modpack-robotics/modpack-robotics.github.io/docs/index.md

---
description: "Build and use ModPack: bill of materials, assembly guides, and software setup for the open-source robot teleoperation backpack."
---

# ModPack

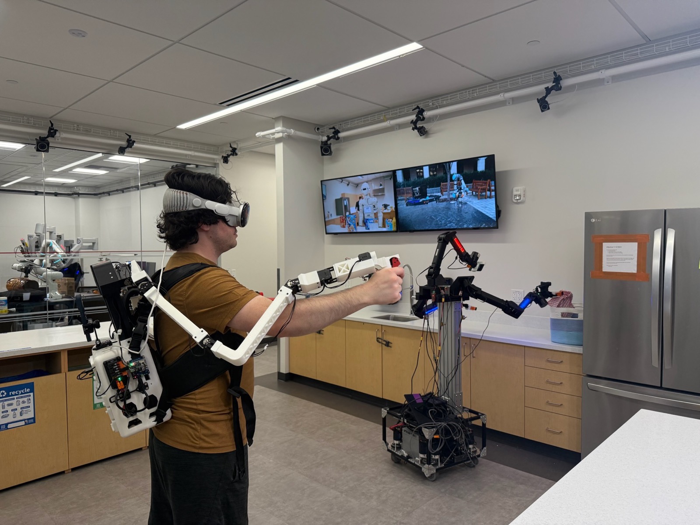
[picture p1: docs/images/arms_teleop_photo.jpg]
ModPack


## Where to Start
These docs contain hardware build instructions as well as a high-level overview of the software layout. For details on running the software for teleoperation, see the software repository.

<div class="nav-cards">
  <a class="nav-card" href="bom/">
    <span class="nav-card-title">Bill of Materials</span>
    <span class="nav-card-desc">Parts list with pricing and vendor links.</span>
  </a>
  <a class="nav-card" href="assembly/">
    <span class="nav-card-title">Assembly</span>
    <span class="nav-card-desc">Build the backpack and leader arms.</span>
  </a>
  <a class="nav-card" href="software/">
    <span class="nav-card-title">Software</span>
    <span class="nav-card-desc">Install and configure the ModPack software stack.</span>
  </a>
</div>
