modpack-robotics/modpack-robotics.github.io/docs/images/arx5_motor_orientation.png

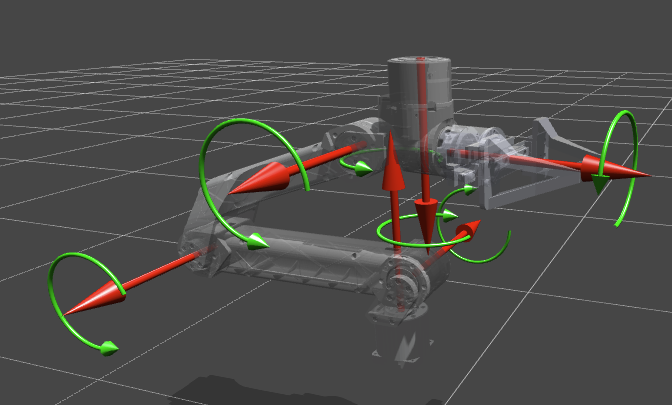
docs/images/arx5_motor_orientation.png
