modpack-robotics/modpack-robotics.github.io/docs/images/backpack_exploded.png

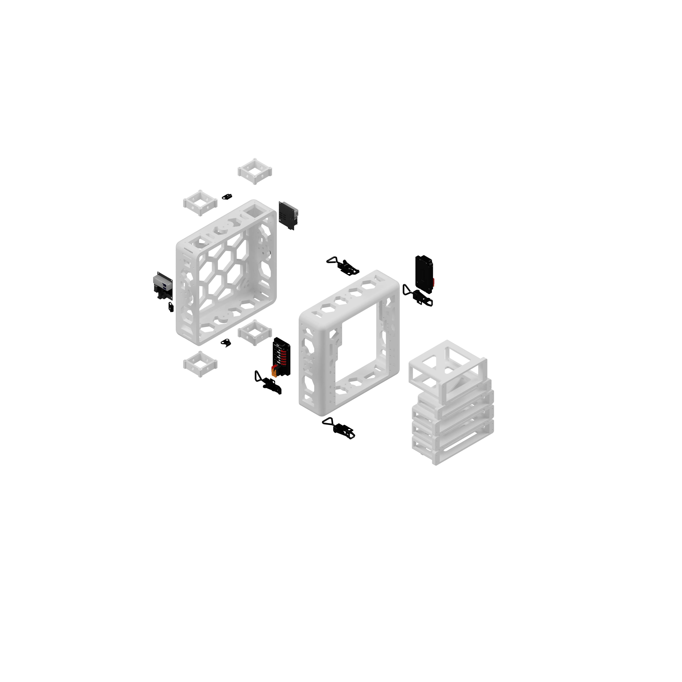
docs/images/backpack_exploded.png
