modpack-robotics/modpack-robotics.github.io/docs/images/rby1m_motor_orientation.png

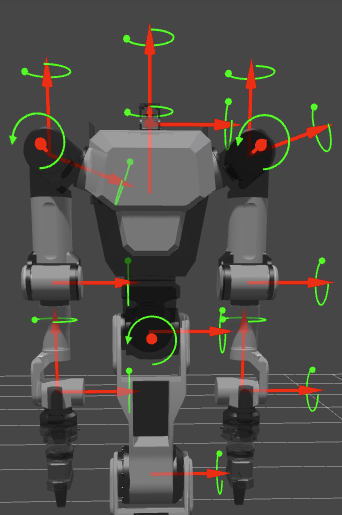
docs/images/rby1m_motor_orientation.png
