modpack-robotics/modpack-robotics.github.io/images/og_card.png

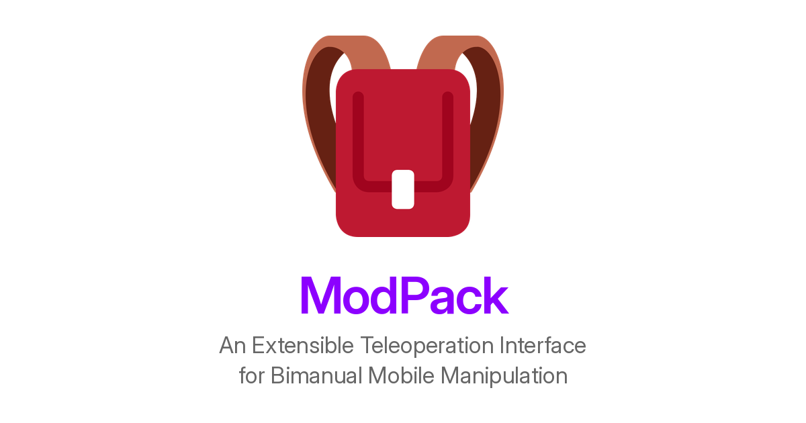
images/og_card.png
