modpack-robotics/modpack-robotics.github.io/images/teaser_v4.png

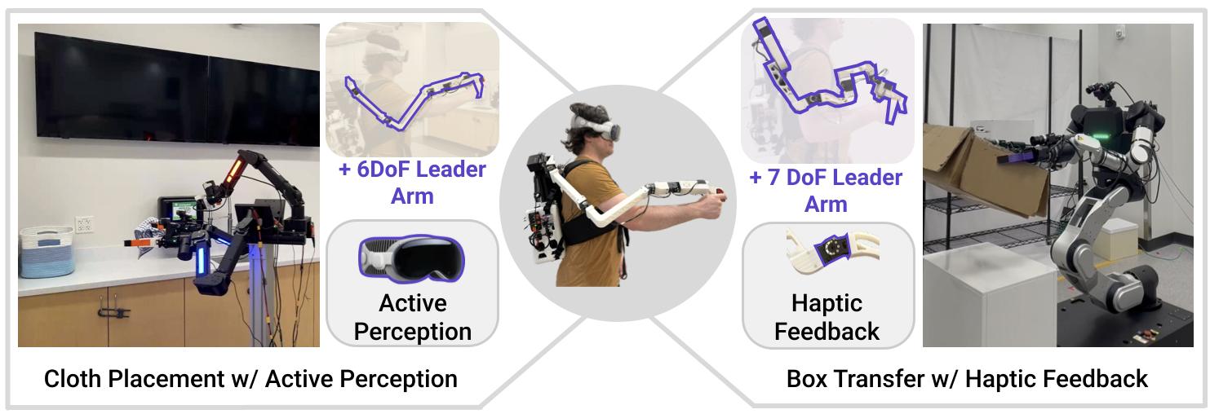
images/teaser_v4.png
