modpack-robotics/modpack-robotics.github.io/videos/posters/all-bad-grasp.jpg

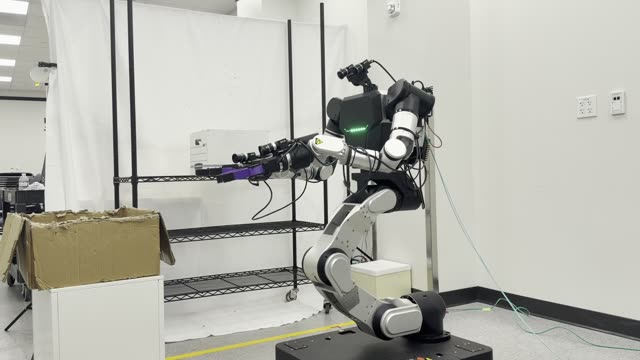
videos/posters/all-bad-grasp.jpg
