modpack-robotics/modpack-robotics.github.io/videos/posters/all-base-overshoot.jpg

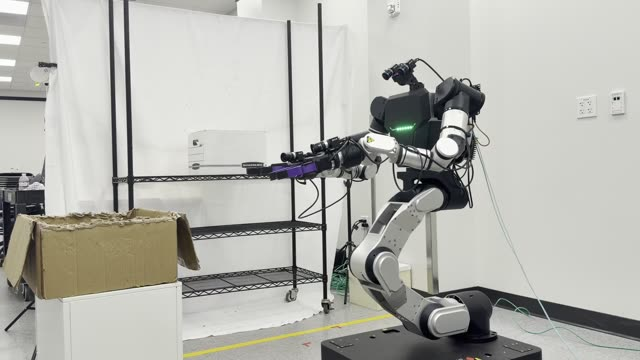
videos/posters/all-base-overshoot.jpg
