modpack-robotics/modpack-robotics.github.io/videos/posters/all-cam-1.jpg

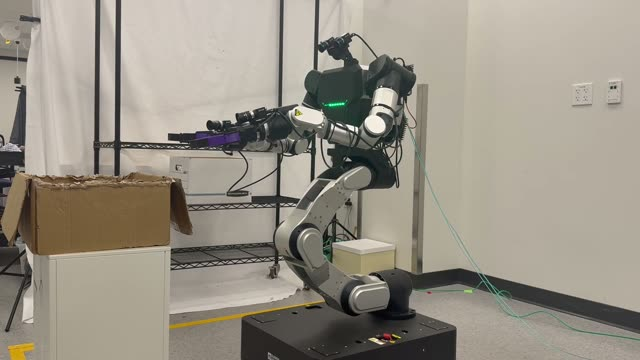
videos/posters/all-cam-1.jpg
