modpack-robotics/modpack-robotics.github.io/videos/posters/all-cam-2.jpg

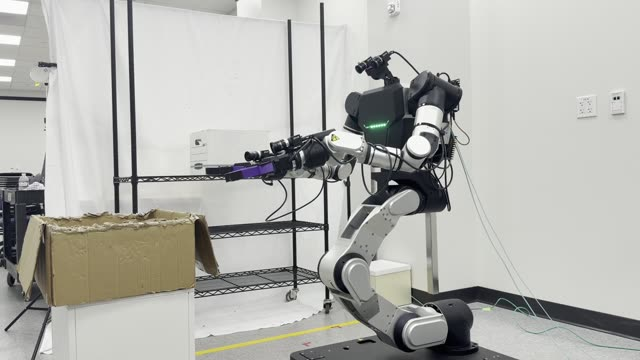
videos/posters/all-cam-2.jpg
