modpack-robotics/modpack-robotics.github.io/videos/posters/all-left-success.jpg

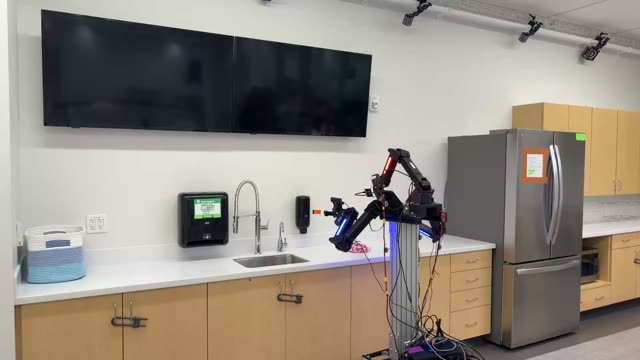
videos/posters/all-left-success.jpg
