modpack-robotics/modpack-robotics.github.io/videos/posters/all-torque-1.jpg

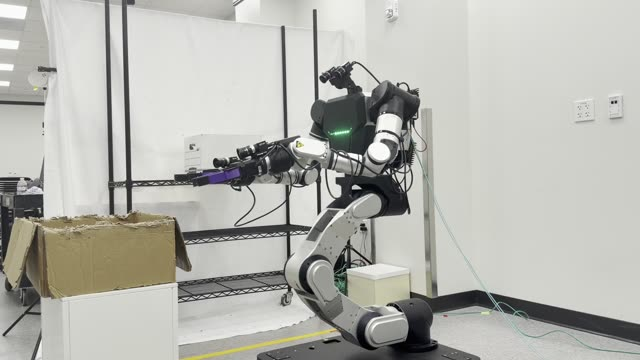
videos/posters/all-torque-1.jpg
