modpack-robotics/modpack-robotics.github.io/videos/posters/all-torque-2.jpg

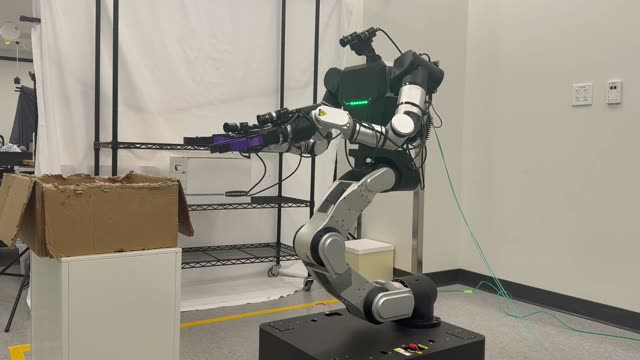
videos/posters/all-torque-2.jpg
