modpack-robotics/modpack-robotics.github.io/videos/posters/elevator_task.jpg

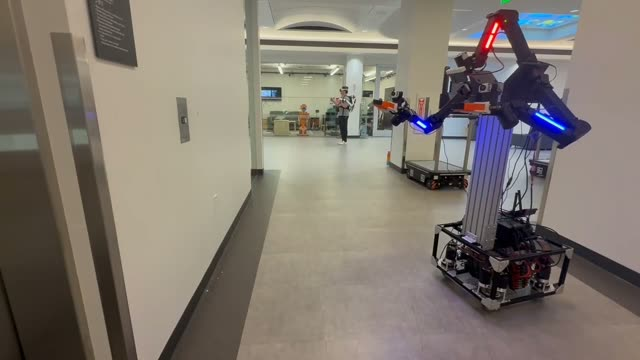
videos/posters/elevator_task.jpg
