modpack-robotics/modpack-robotics.github.io/videos/posters/fail-grasp-unblurred.jpg

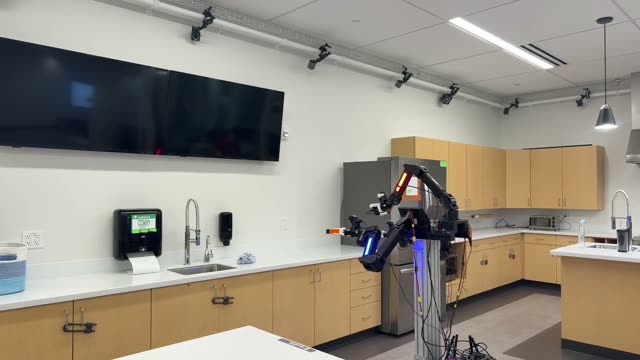
videos/posters/fail-grasp-unblurred.jpg
