modpack-robotics/modpack-robotics.github.io/videos/posters/head-near-collision.jpg

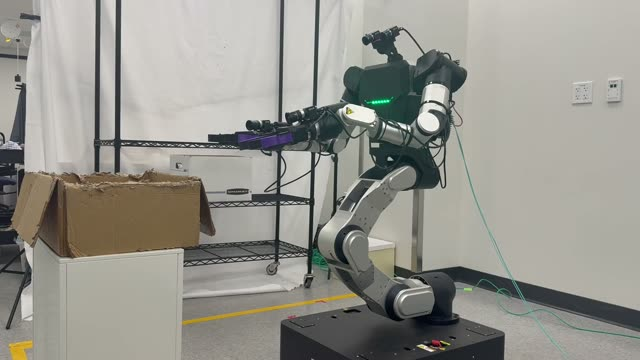
videos/posters/head-near-collision.jpg
