modpack-robotics/modpack-robotics.github.io/videos/posters/head-success-2.jpg

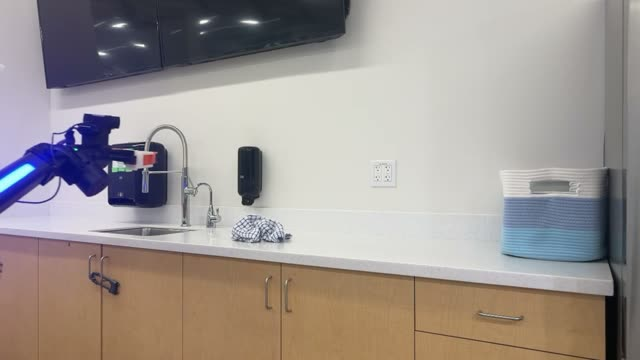
videos/posters/head-success-2.jpg
