modpack-robotics/modpack-robotics.github.io/videos/posters/head-success.jpg

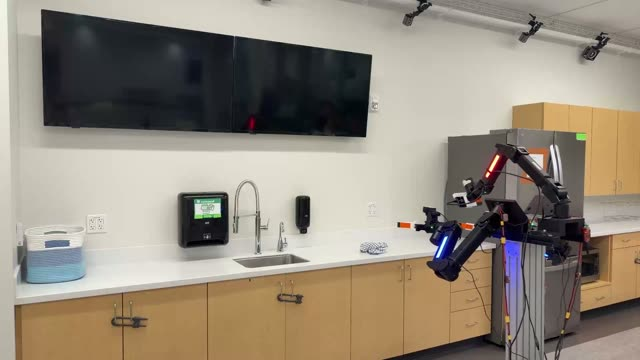
videos/posters/head-success.jpg
