modpack-robotics/modpack-robotics.github.io/videos/posters/kitchen_task.jpg

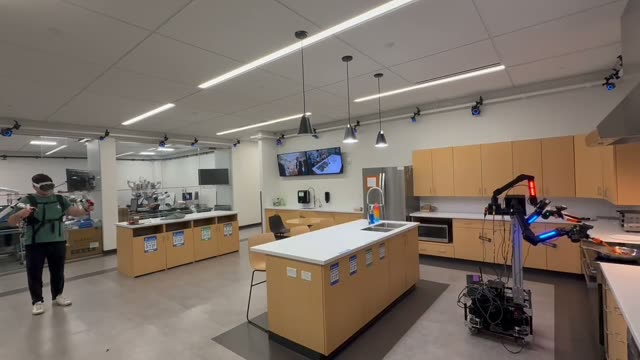
videos/posters/kitchen_task.jpg
