modpack-robotics/modpack-robotics.github.io/videos/posters/recycle_can.jpg

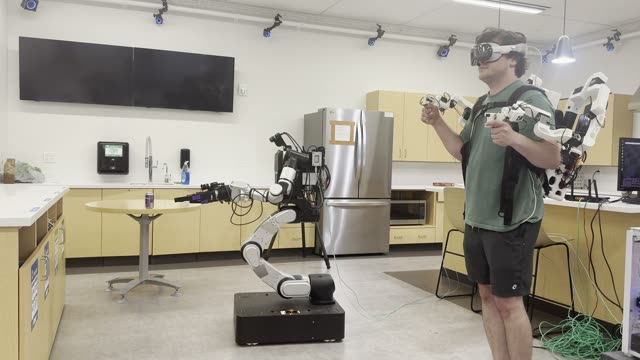
videos/posters/recycle_can.jpg
