modpack-robotics/modpack-robotics.github.io/videos/posters/Task 1 Teleop.jpg

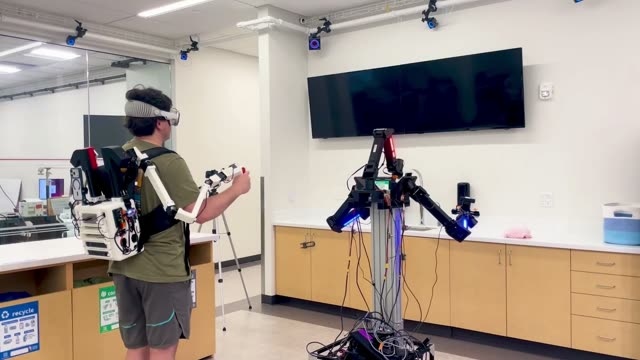
videos/posters/Task 1 Teleop.jpg
