modpack-robotics/modpack-robotics.github.io/videos/posters/task_2_teleop.jpg

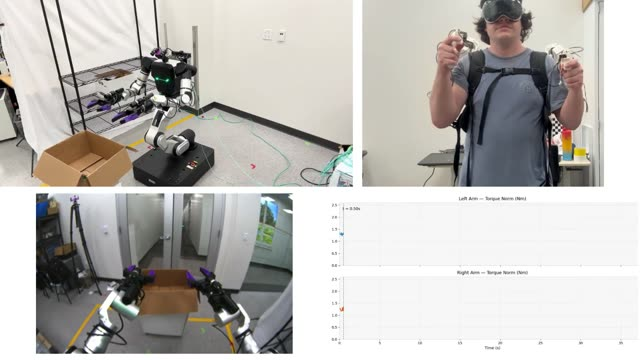
videos/posters/task_2_teleop.jpg
