modpack-robotics/modpack-robotics.github.io/videos/posters/task_2_teleop_lower.jpg

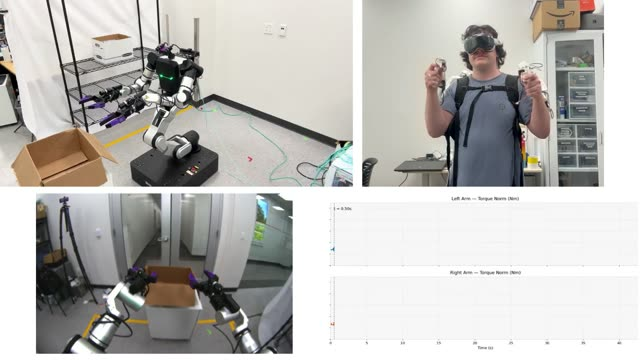
videos/posters/task_2_teleop_lower.jpg
