modpack-robotics/modpack-robotics.github.io/videos/posters/teaser.jpg

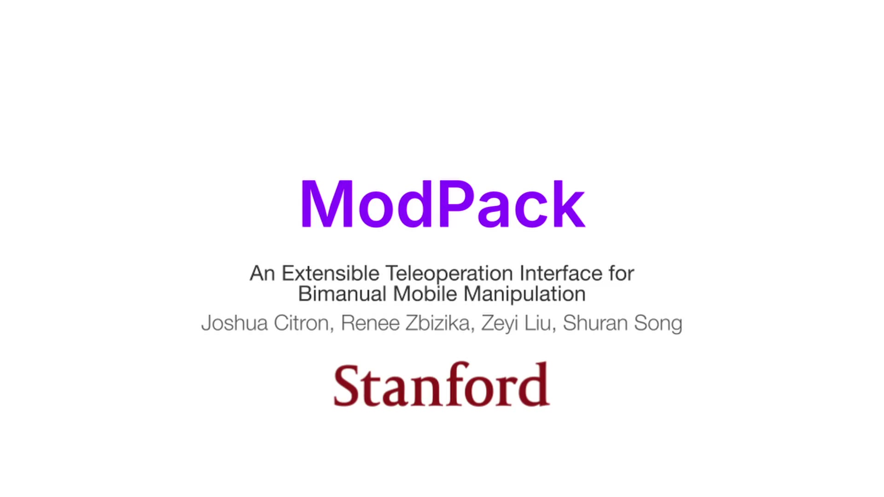
videos/posters/teaser.jpg
