modpack-robotics/modpack-robotics.github.io/docs/bom.md

---
description: Full parts list for building the ModPack teleoperation backpack and leader arms, with pricing and vendor links.
---

# Bill of Materials

### Backpack

| Item | Unit Cost | Qty | Total | Notes |
|---|---|-----|---|---|
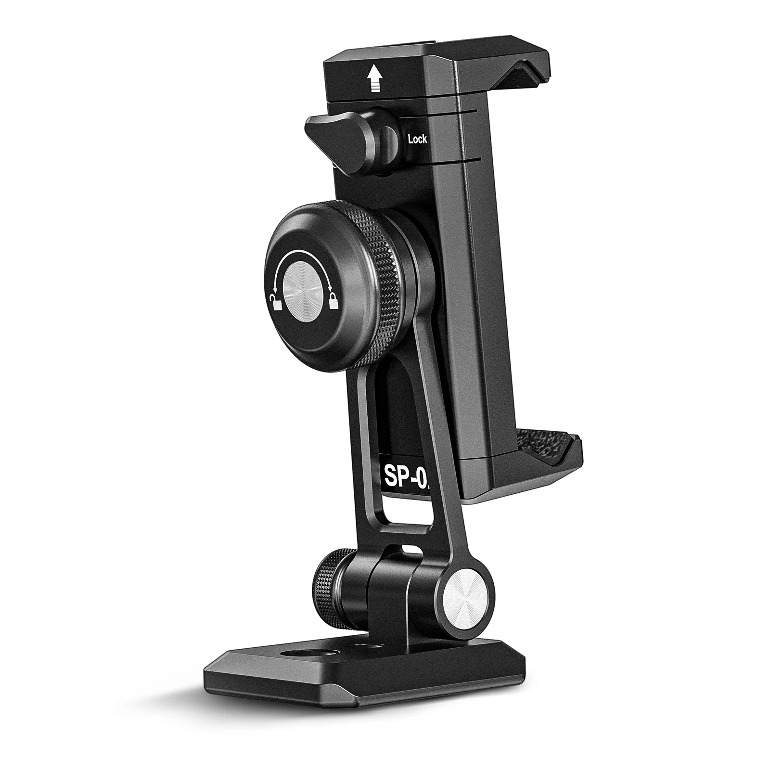
[picture p26: docs/images/bom/phone_mount.png]
| <div class="bom-item bom-item-lg"><span>Phone Mount</span></div> | $27.99 [[Amazon](https://www.amazon.com/NEEWER-SP-02-Cleaning-Cloth-Compatible/dp/B0FHW3ZXNM)] | 1 | $27.99 | |
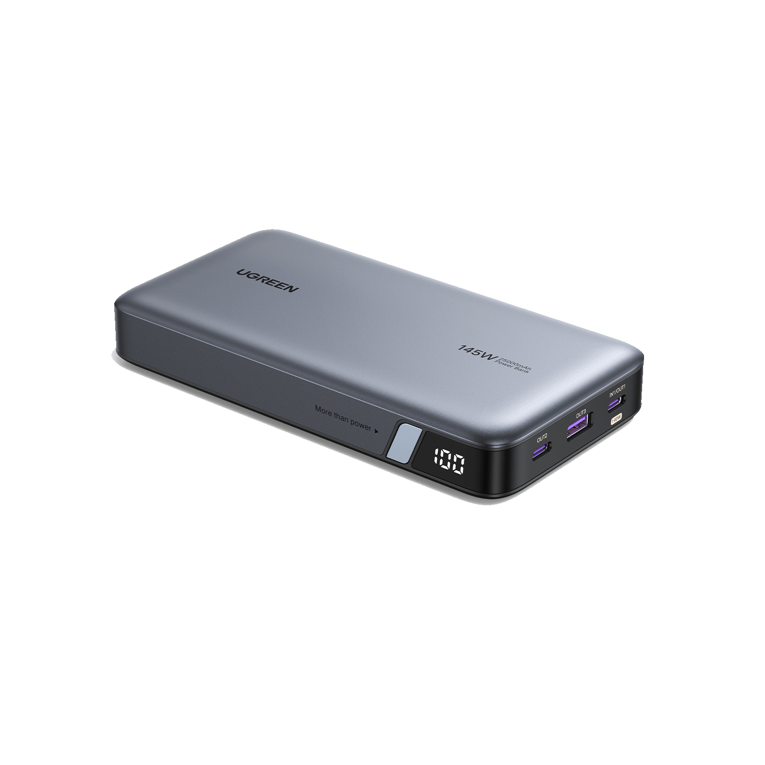
[picture p27: docs/images/bom/ugreen-145w.png]
| <div class="bom-item bom-item-lg" id="ugreen-145w"><span>UGREEN 145W Power Bank</span></div> | $109.99 [[UGREEN](https://www.ugreen.com/products/ugreen-145w-power-bank-for-laptop)] | 3 | $329.97 | |
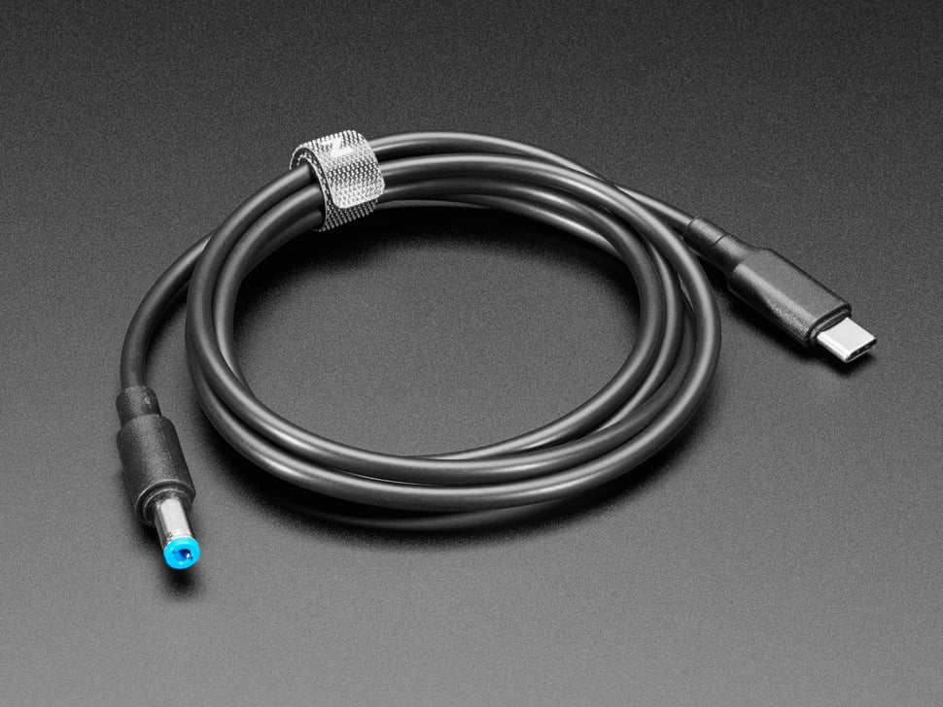
[picture p28: docs/images/bom/adafruit-5450.jpg]
| <div class="bom-item bom-item-lg" id="pd-trigger-cable"><span>PD Trigger Cable</span></div> | $7.95 [[Adafruit](https://www.adafruit.com/product/5450)] | 2 | $15.90 | |
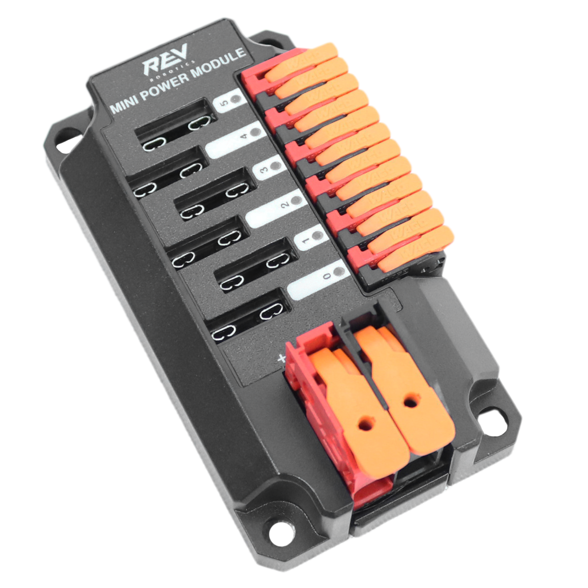
[picture p29: docs/images/bom/rev-mini-power-module.png]
| <div class="bom-item bom-item-lg" id="rev-mini-pdp"><span>Mini Power Module</span></div> | $38.00 [[REV Robotics](https://www.revrobotics.com/rev-11-1956/)] | 2 | $76.00 | |
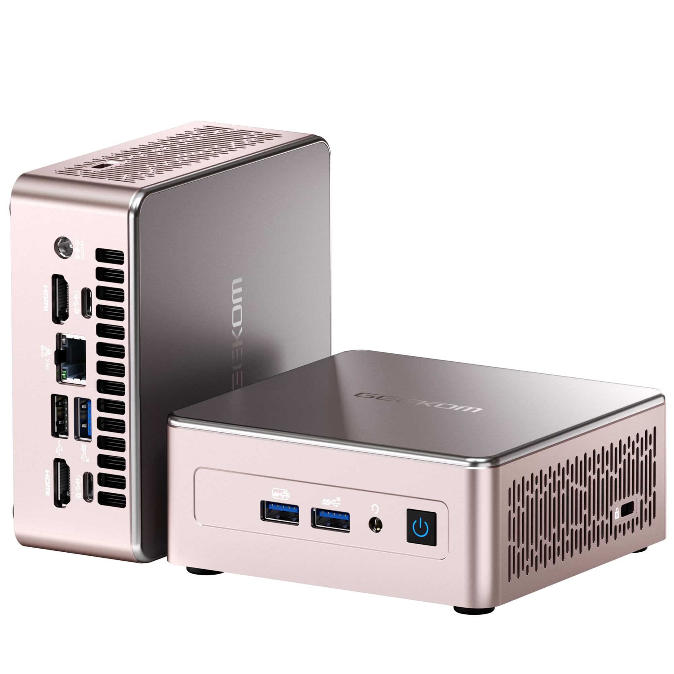
[picture p30: docs/images/bom/geekom-a5.jpg]
| <div class="bom-item bom-item-lg" id="geekom-a5"><span>GEEKOM A5 Mini PC</span></div> | $439.00 [[GEEKOM](https://www.geekompc.com/geekom-a5-mini-pc/)] | 1 | $439.00 | |
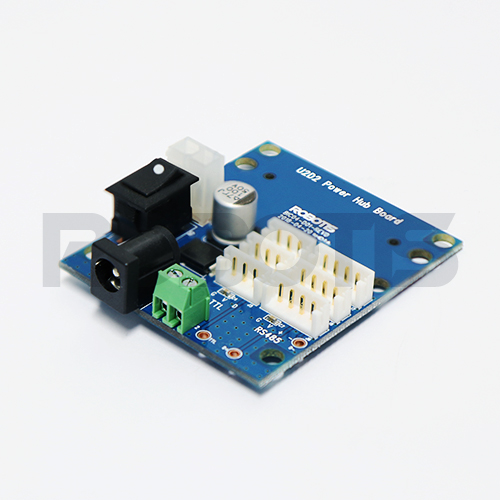
[picture p31: docs/images/bom/u2d2-power-hub.jpg]
| <div class="bom-item bom-item-lg" id="u2d2-power-hub"><span>U2D2 Power Hub Board</span></div> | $21.85 [[Robotis](https://www.robotis.us/u2d2-power-hub-board-set/)] | 2 | $43.70 | |
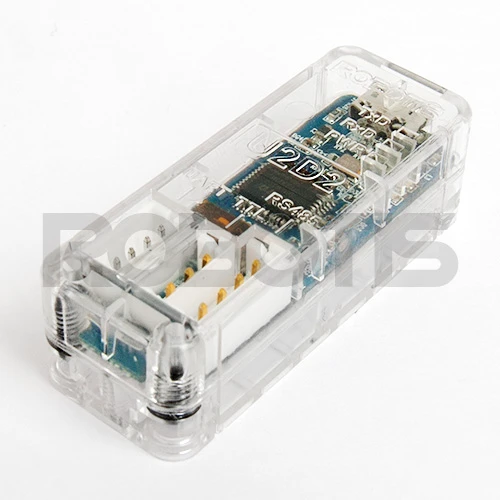
[picture p32: docs/images/bom/u2d2.webp]
| <div class="bom-item bom-item-lg" id="u2d2"><span>U2D2</span></div> | $36.92 [[Robotis](https://www.robotis.us/u2d2/)] | 2 | $73.84 | |
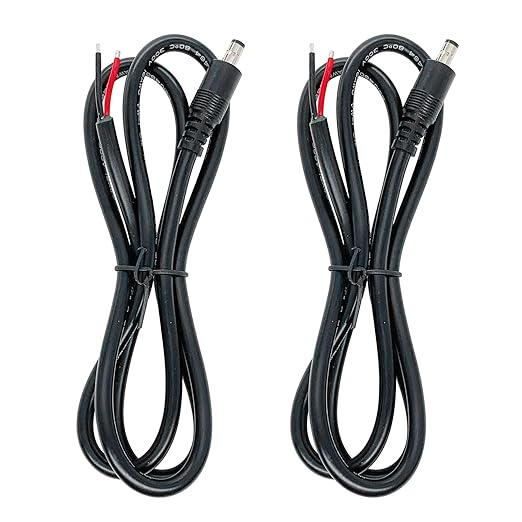
[picture p33: docs/images/bom/dc-barrel-male.jpg]
| <div class="bom-item bom-item-lg" id="dc-barrel-male"><span>DC Barrel Male Pigtail</span></div> | $13.99 [[Amazon](https://www.amazon.com/dp/B0CYBXK4ZW)] | 2 | $27.98 | |
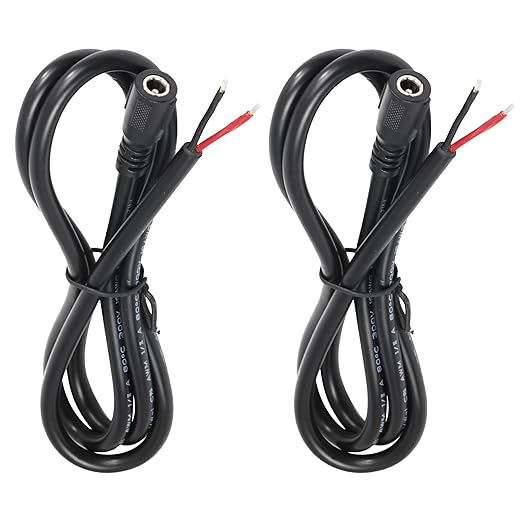
[picture p34: docs/images/bom/dc-barrel-female.jpg]
| <div class="bom-item bom-item-lg" id="dc-barrel-female"><span>DC Barrel Female Pigtail</span></div> | $12.49 [[Amazon](https://www.amazon.com/dp/B0DLW8692F)] | 2 | $24.98 | |
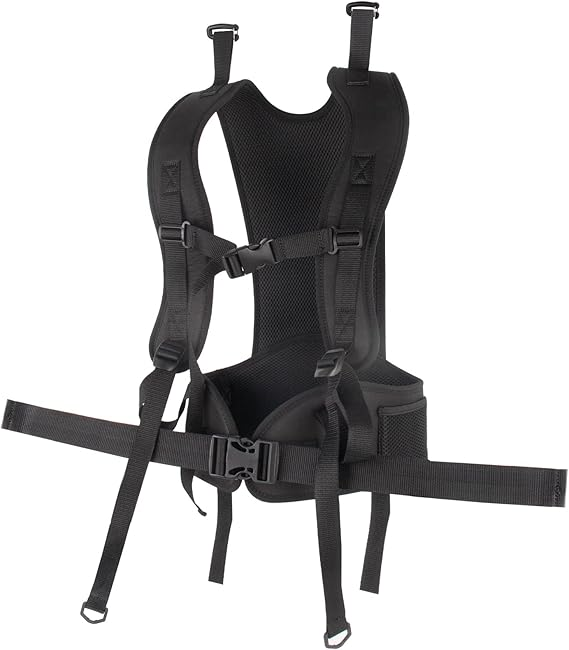
[picture p35: docs/images/bom/backpack-straps.jpg]
| <div class="bom-item bom-item-lg"><span>Backpack Straps</span></div> | $38.89 [[Amazon](https://www.amazon.com/dp/B0DHL1KNZ7)] | 1 | $38.89 | |
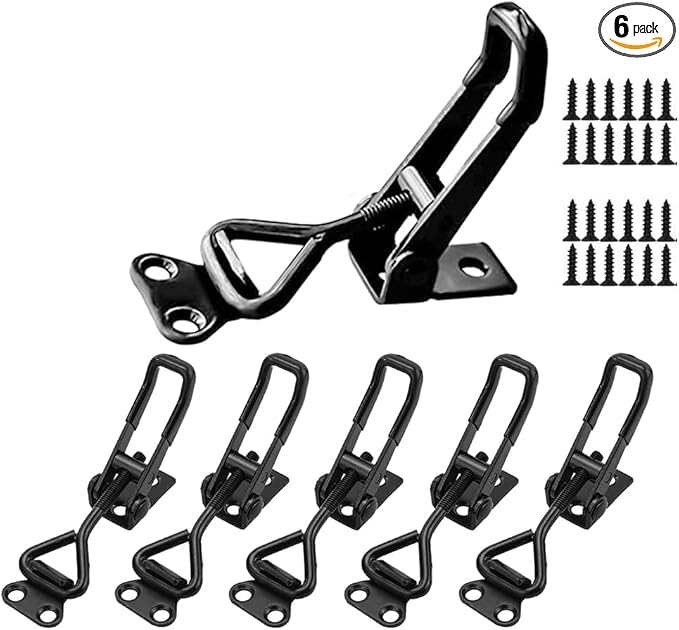
[picture p36: docs/images/bom/latch.jpg]
| <div class="bom-item bom-item-lg" id="latch"><span>Latch</span></div> | $7.95 [[Amazon](https://www.amazon.com/dp/B0C7BGH1Y9)] | 1 | $7.95 | |
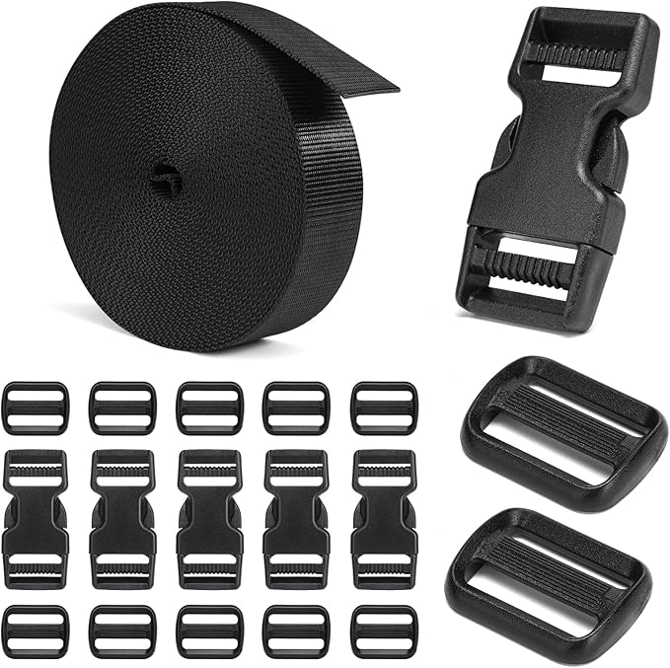
[picture p37: docs/images/bom/straps.jpg]
| <div class="bom-item bom-item-lg"><span>Shoulder Straps</span></div> | $9.99 [[Amazon](https://www.amazon.com/dp/B08LD8CJ8D)] | 1 | $9.99 | |
| <div class="bom-item" id="93625A200"><span>93625A200<br><small>M5 Nylon Lock Nut</small></span></div> | $9.62 [[McMaster](https://www.mcmaster.com/93625A200/)] | 1 pkg | $9.62 | |
| <div class="bom-item"><span>94180A321<br><small>M2.5x3.4 Heat-Set Insert</small></span></div> | $17.56 [[McMaster](https://www.mcmaster.com/94180A321/)] | 1 pkg | $17.56 | Shared with arms — one package total |
| <div class="bom-item" id="91290A252"><span>91290A252<br><small>M5x25 Socket Head Screw</small></span></div> | $10.96 [[McMaster](https://www.mcmaster.com/91290A252/)] | 1 pkg | $10.96 | |
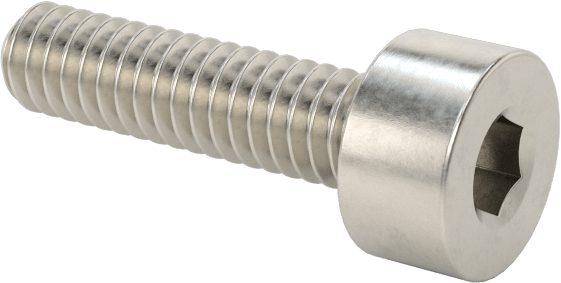
[picture p38: docs/images/bom/91292A832.png]
| <div class="bom-item" id="91292A832"><span>91292A832<br><small>M2x8 SS Socket Head</small></span></div> | $7.74 [[McMaster](https://www.mcmaster.com/91292A832/)] | 1 pkg | $7.74 | |
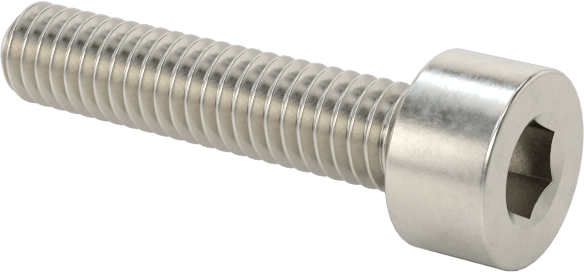
[picture p39: docs/images/bom/91292A016.png]
| <div class="bom-item" id="91292A016"><span>91292A016<br><small>M2.5x12 SS Socket Head</small></span></div> | $7.75 [[McMaster](https://www.mcmaster.com/91292A016/)] | 1 pkg | $7.75 | |
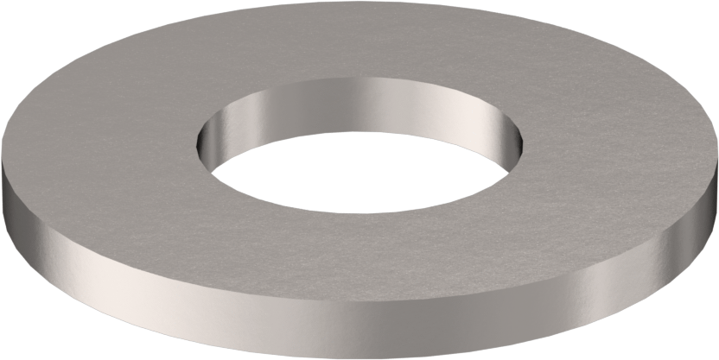
[picture p40: docs/images/bom/93475A210.png]
| <div class="bom-item" id="93475A210"><span>93475A210<br><small>M2.5 SS Washer</small></span></div> | $2.89 [[McMaster](https://www.mcmaster.com/93475A210/)] | 1 pkg | $2.89 | |
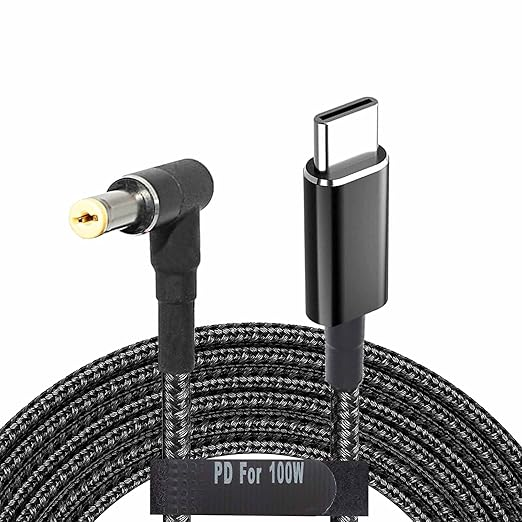
[picture p41: docs/images/bom/pc-cable.jpg]
| <div class="bom-item bom-item-lg" id="pc-cable"><span>100W PD 19V Laptop Charging Cable</span></div> | $14.98 [[Amazon](https://www.amazon.com/dp/B09X3V58M4)] | 1 | $14.98 | |
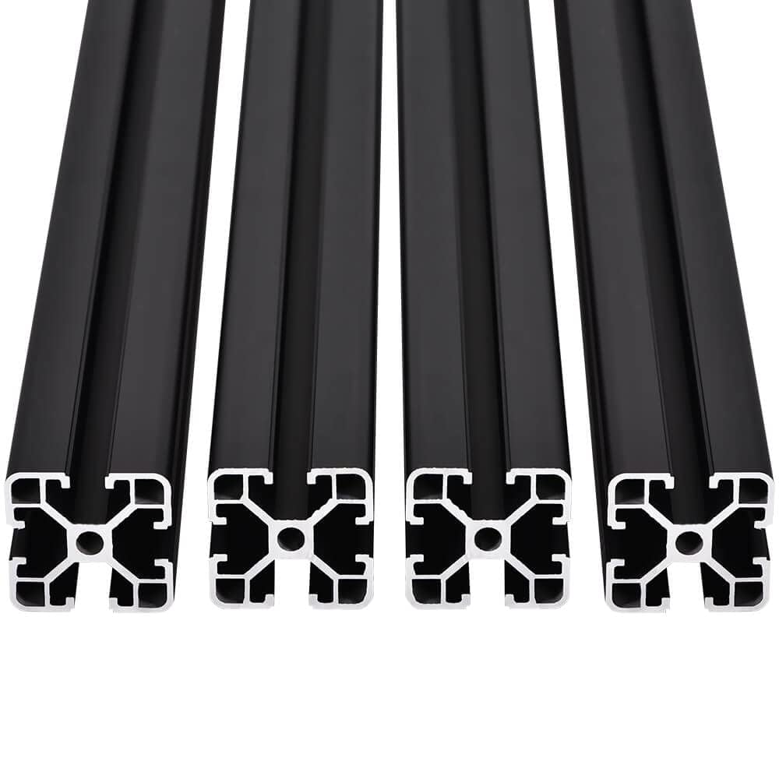
[picture p42: docs/images/bom/40x40-extrusion.jpeg]
| <div class="bom-item bom-item-lg" id="40x40-extrusion"><span>40×40 T-Slot Aluminum Extrusion</span></div> | $52.99 [[Amazon](https://www.amazon.com/dp/B09MWCL2WH)] | 1 pkg | $52.99 | Pack of 4 |
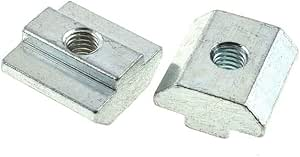
[picture p43: docs/images/bom/t-slot-sliding-nuts.jpg]
| <div class="bom-item bom-item-lg" id="t-slot-sliding-nuts"><span>T-Slot Sliding T-Nuts</span></div> | $8.99 [[Amazon](https://www.amazon.com/dp/B085BYLWJ2)] | 2 pkg | $17.98 | |

**Subtotal: $1,251.11**

---

### General Leader Arm (Both Variants)

| Item | Unit Cost | Qty | Total |
|---|---|-----|---|
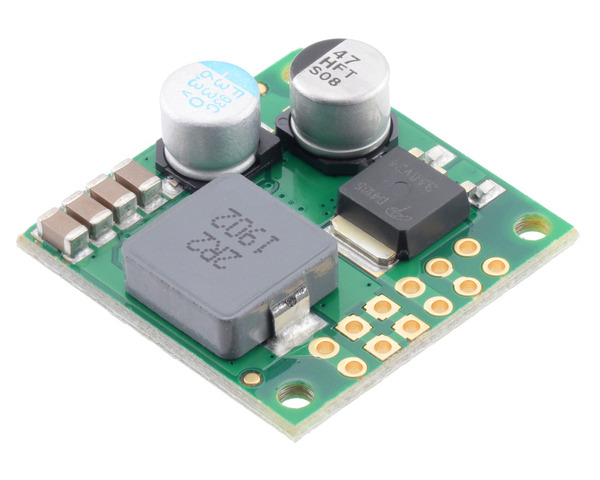
[picture p44: docs/images/bom/pololu-4091.jpg]
| <div class="bom-item"><span>D36V50F5 (5V Stepdown)</span></div> | $39.95 [[Pololu](https://www.pololu.com/product/4091)] | 2 | $79.90 |
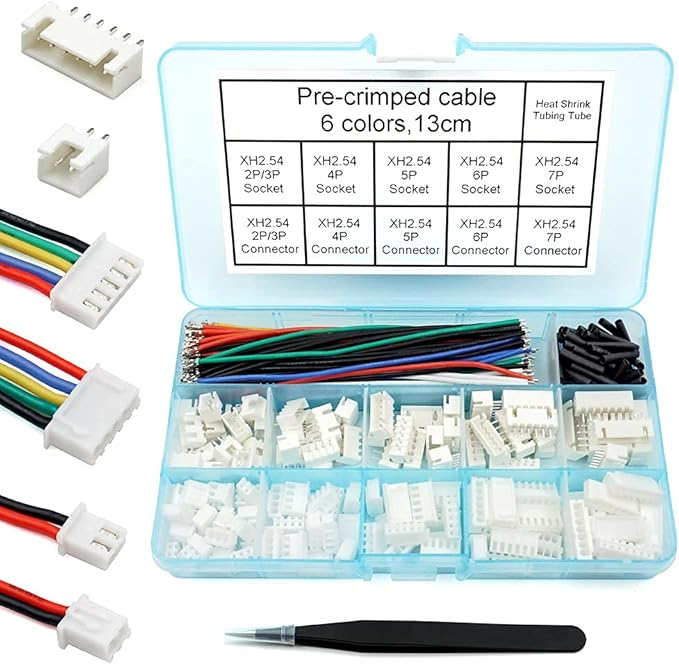
[picture p45: docs/images/bom/cables.jpg]
| <div class="bom-item" id="jst-wire-kit"><span>JST Connector Wire Kit</span></div> | $16.99 [[Amazon](https://www.amazon.com/dp/B08G188ZQ8)] | 1 pkg | $16.99 |
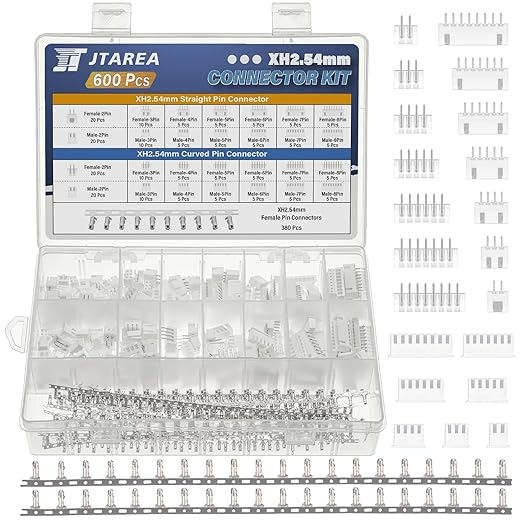
[picture p46: docs/images/bom/kit.jpg]
| <div class="bom-item" id="jst-xh-kit"><span>JST XH 2.54mm Connector Kit</span></div> | $8.99 [[Amazon](https://www.amazon.com/dp/B0F5QBR5F4)] | 1 pkg | $8.99 |
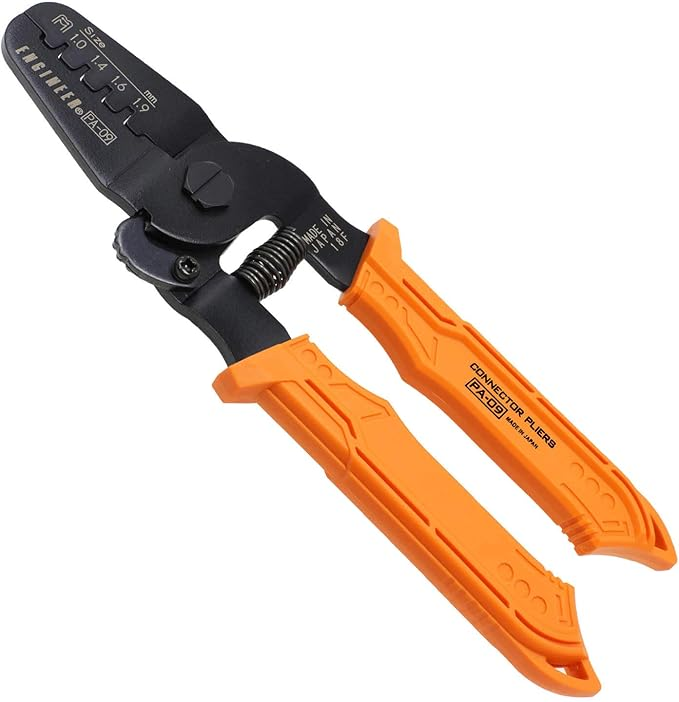
[picture p47: docs/images/bom/engineer_pa09.jpg]
| <div class="bom-item" id="engineer-pa09"><span>ENGINEER PA-09 Crimper</span></div> | $41.59 [[Amazon](https://www.amazon.com/dp/B002AVVO7K)] | 1 | $41.59 |
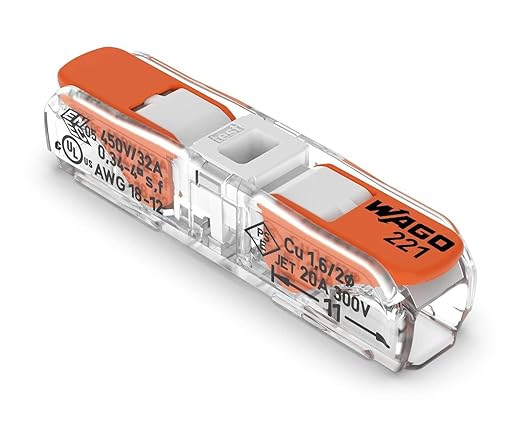
[picture p48: docs/images/bom/wago.jpg]
| <div class="bom-item" id="wago"><span>WAGO 221-2401 Lever Nuts</span></div> | $9.95 [[Amazon](https://www.amazon.com/dp/B0GFFF52V5)] | 1 pkg | $9.95 |
| <div class="bom-item"><span>92125A086<br><small>M2.5x8 SS Flat Head</small></span></div> | $6.50 [[McMaster](https://www.mcmaster.com/92125A086/)] | 1 pkg | $6.50 |
| <div class="bom-item"><span>94180A323<br><small>M2.5x5.6 Heat-Set Insert</small></span></div> | $24.72 [[McMaster](https://www.mcmaster.com/94180A323/)] | 1 pkg | $24.72 |
| <div class="bom-item"><span>91294A020<br><small>M2.5x12 Black Flat Head</small></span></div> | $6.45 [[McMaster](https://www.mcmaster.com/91294A020/)] | 1 pkg | $6.45 |
| <div class="bom-item" id="94180A321"><span>94180A321<br><small>M2.5x3.4 Heat-Set Insert</small></span></div> | $17.56 [[McMaster](https://www.mcmaster.com/94180A321/)] | 1 pkg | $17.56 |
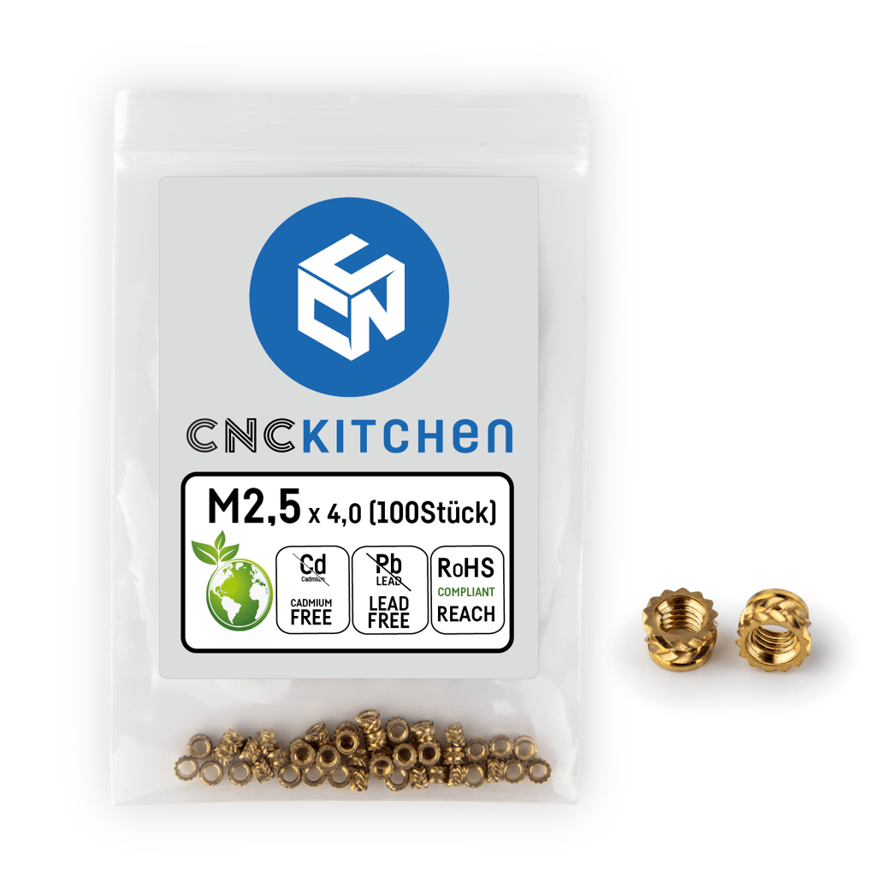
[picture p49: docs/images/bom/heat-set-insert-m2.png]
| <div class="bom-item" id="m2-heat-set"><span>M2 Heat-Set Inserts</span></div> | $8.99 [[Amazon](https://www.amazon.com/dp/B0CS6XJSSL)] | 1 pkg | $8.99 |
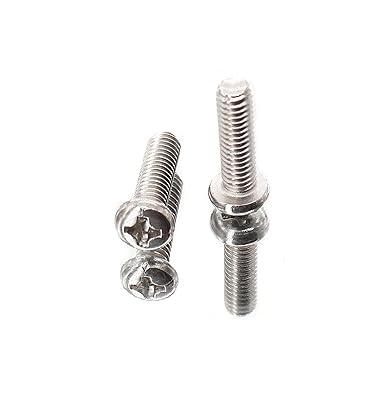
[picture p50: docs/images/bom/pan_head.jpg]
| <div class="bom-item" id="m2x6-screw"><span>M2x6 Pan Head Screw</span></div> | $4.69 [[Amazon](https://www.amazon.com/dp/B0CMCTX529)] | 1 pkg | $4.69 |
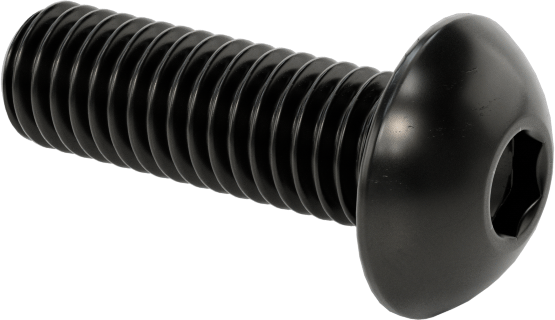
[picture p51: docs/images/bom/97763A822.png]
| <div class="bom-item" id="97763A822"><span>97763A822<br><small>M5x16 SS Button Head</small></span></div> | $6.66 [[McMaster](https://www.mcmaster.com/97763A822/)] | 1 pkg | $6.66 |
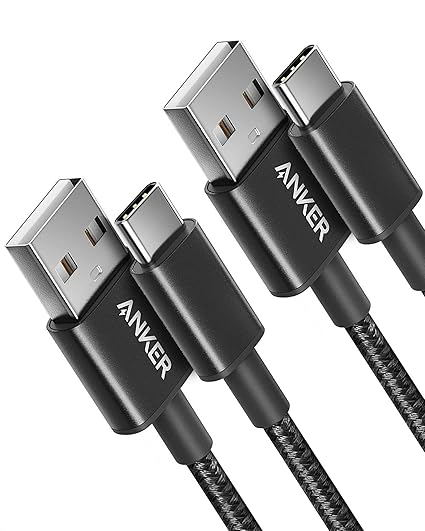
[picture p52: docs/images/bom/usbc-to-usb.jpg]
| <div class="bom-item" id="usbc-to-usb"><span>USB-C to USB Cable</span></div> | $8.99 [[Amazon](https://www.amazon.com/dp/B07DD5YHMH)] | 1 pkg | $8.99 |

**Subtotal: $241.98**

---

### ARX5 Leader Arm (6-DoF)

| Item | Unit Cost | Qty | Total |
|---|---|-----|---|
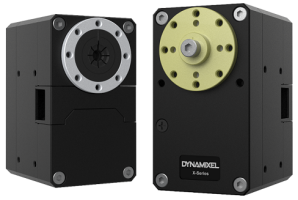
[picture p53: docs/images/bom/xm540-w270-t.png]
| <div class="bom-item"><span>XM540-W270-T</span></div> | $482.89 [[Robotis](https://robotis.us/dynamixel-xm540-w270-t/)] | 2 | $965.78 |
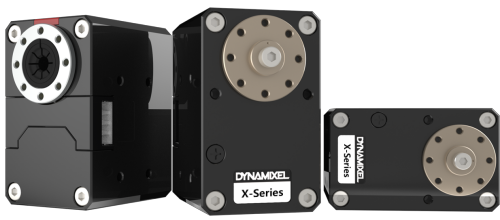
[picture p54: docs/images/bom/xm430-w350-t.png]
| <div class="bom-item"><span>XM430-W350-T</span></div> | $310.39 [[Robotis](https://www.robotis.us/dynamixel-xm430-w350-t/)] | 2 | $620.78 |
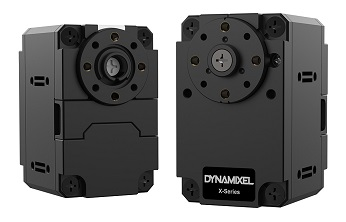
[picture p55: docs/images/bom/xl430-w250-t.png]
| <div class="bom-item"><span>XL430-W250-T</span></div> | $45.36 [[Robotis](https://www.robotis.us/dynamixel-xl430-w250-t/)] | 2 | $90.72 |
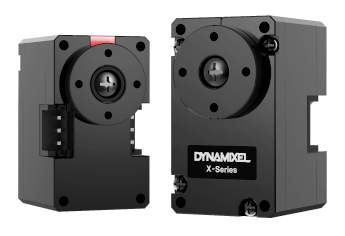
[picture p56: docs/images/bom/xl330-m288-t.png]
| <div class="bom-item"><span>XL330-M288-T</span></div> | $27.49 [[Robotis](https://www.robotis.us/dynamixel-xl330-m288-t/)] | 1 | $27.49 |
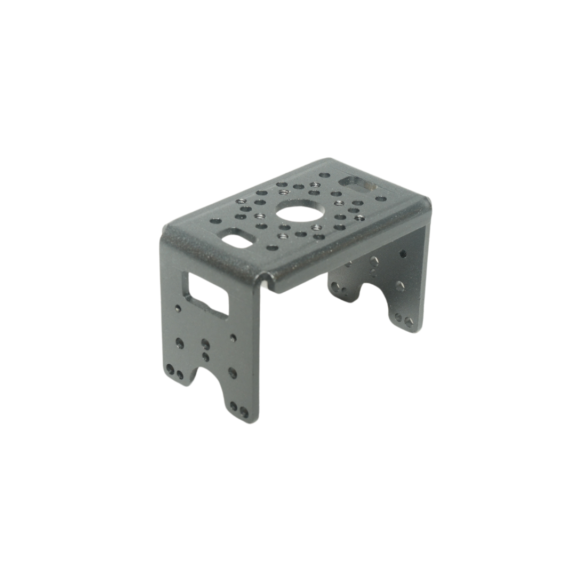
[picture p57: docs/images/bom/fr13.png]
| <div class="bom-item"><span>FR13</span></div> | $76.71 [[Robotis](https://www.robotis.us/fr13-h101k-set/)] | 2 | $153.42 |
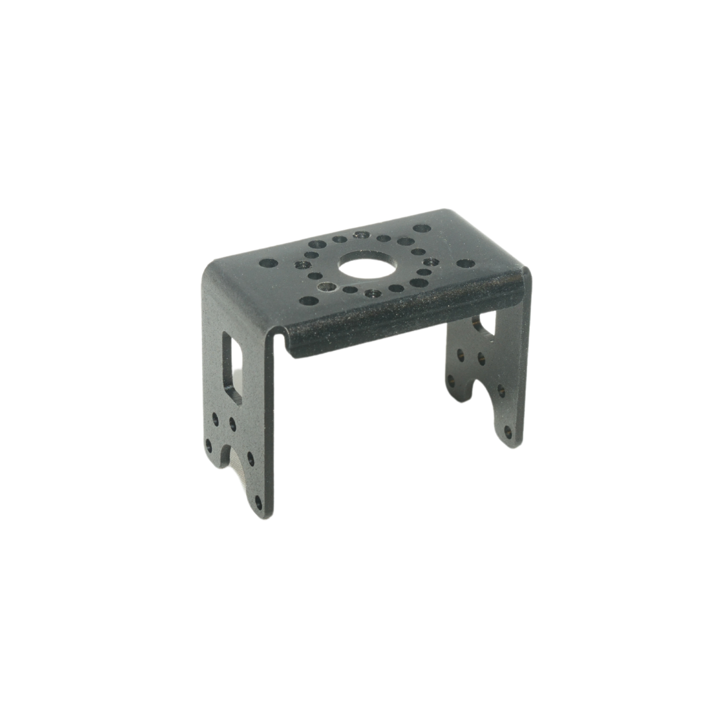
[picture p58: docs/images/bom/fr12.png]
| <div class="bom-item"><span>FR12</span></div> | $46.69 [[Robotis](https://www.robotis.us/fr12-h101k-set/)] | 3 | $140.07 |

**Subtotal: $1,998.26**

---

### RB-Y1m Leader Arm (7-DoF)

| Item | Unit Cost | Qty | Total |
|---|---|-----|---|
| <div class="bom-item"><span>XM540-W270-T</span></div> | $482.89 [[Robotis](https://robotis.us/dynamixel-xm540-w270-t/)] | 5 | $2,414.45 |
| <div class="bom-item"><span>XM430-W350-T</span></div> | $310.39 [[Robotis](https://www.robotis.us/dynamixel-xm430-w350-t/)] | 1 | $310.39 |
| <div class="bom-item"><span>XM430-W210-T</span></div> | $310.39 [[Robotis](https://www.robotis.us/dynamixel-xm430-w210-t/)] | 1 | $310.39 |
| <div class="bom-item"><span>XL330-M288-T</span></div> | $27.49 [[Robotis](https://www.robotis.us/dynamixel-xl330-m288-t/)] | 1 | $27.49 |
| <div class="bom-item"><span>FR13</span></div> | $76.71 [[Robotis](https://www.robotis.us/fr13-h101k-set/)] | 5 | $383.55 |
| <div class="bom-item" id="fr12-bracket-kit"><span>FR12</span></div> | $46.69 [[Robotis](https://www.robotis.us/fr12-h101k-set/)] | 1 | $46.69 |

**Subtotal: $3,492.96**

---

### Off-the-Shelf Devices

Required only for their respective modules; not included in the build subtotals above since many users already own them.

| Item | Unit Cost | Qty | Total | Notes |
|---|---|-----|---|---|
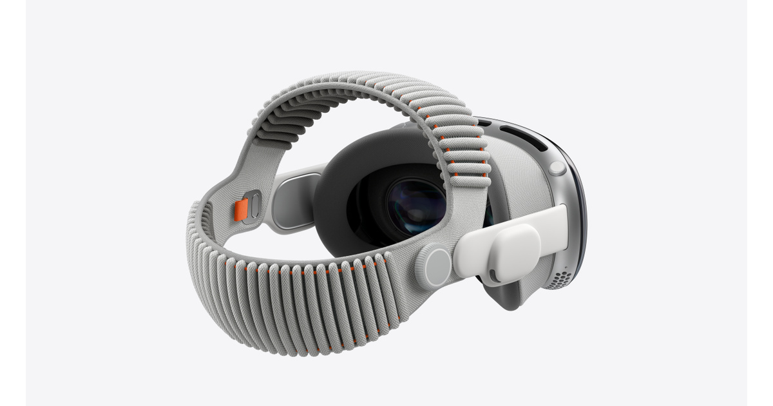
[picture p59: docs/images/bom/apple-vision-pro.jpg]
| <div class="bom-item bom-item-lg" id="apple-vision-pro"><span>Apple Vision Pro</span></div> | $3,699.00 [[Apple](https://www.apple.com/apple-vision-pro/)] | 1 | $3,699.00 | Head-tracking module |
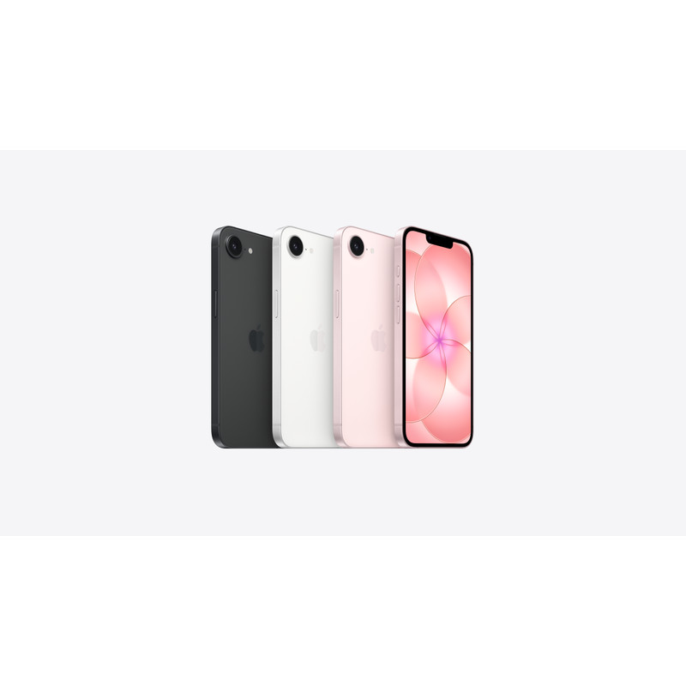
[picture p60: docs/images/bom/iphone-17e.jpg]
| <div class="bom-item bom-item-lg" id="iphone"><span>iPhone</span></div> | from $599.00 [[Apple](https://www.apple.com/shop/buy-iphone/iphone-17e)] | 1 | $599.00 | Base-control module; any recent iPhone works (mounts on the backpack phone mount) |
