modpack-robotics/modpack-robotics.github.io/docs/files/arx5/gripper.step

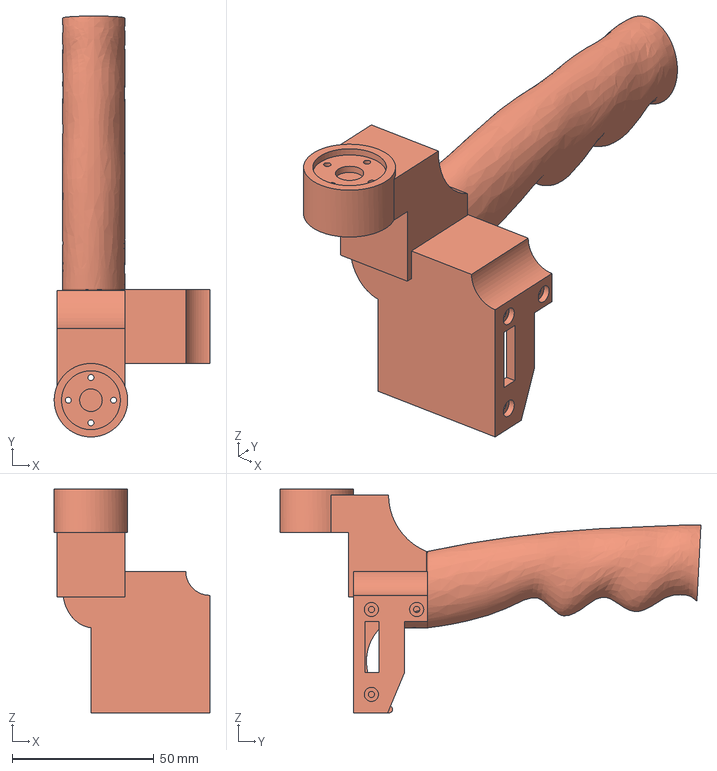
[picture p61: CAD file, 2026-07-21]
docs/files/arx5/gripper.step
55.0 x 148.7 x 79.0 mm
