modpack-robotics/modpack-robotics.github.io/docs/files/backpack/pc-holder.step

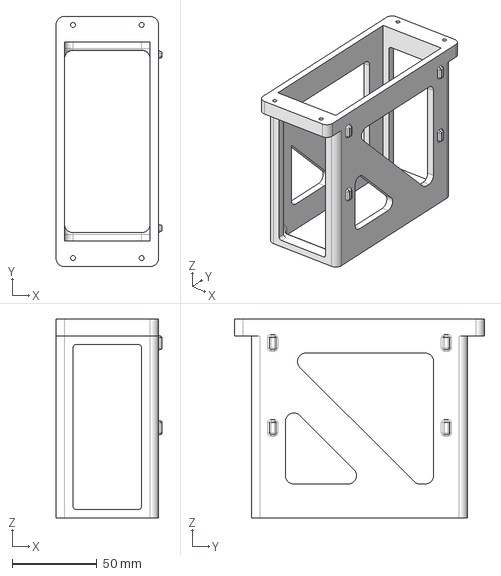
[picture p62: CAD file, 2026-07-21]
docs/files/backpack/pc-holder.step
62.4 x 147.2 x 117.1 mm
