modpack-robotics/modpack-robotics.github.io/docs/files/rby1m/left-shoulder.step

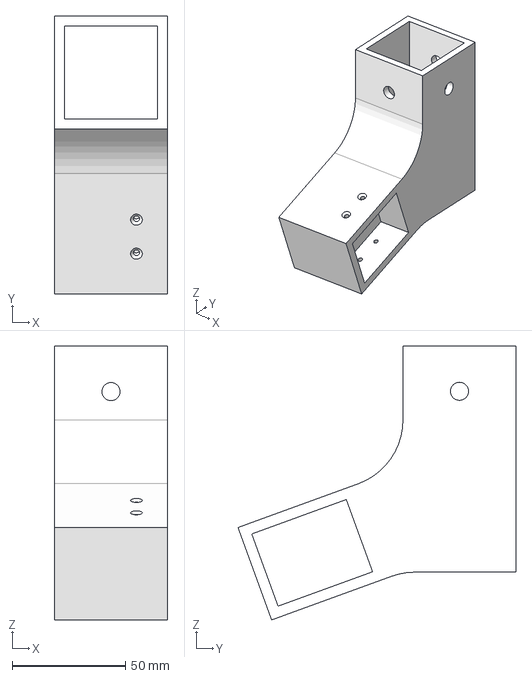
[picture p63: CAD file, 2026-07-21]
docs/files/rby1m/left-shoulder.step
50.0 x 123.0 x 121.1 mm
