modpack-robotics/modpack-robotics.github.io/docs/files/shared/trigger-right.step

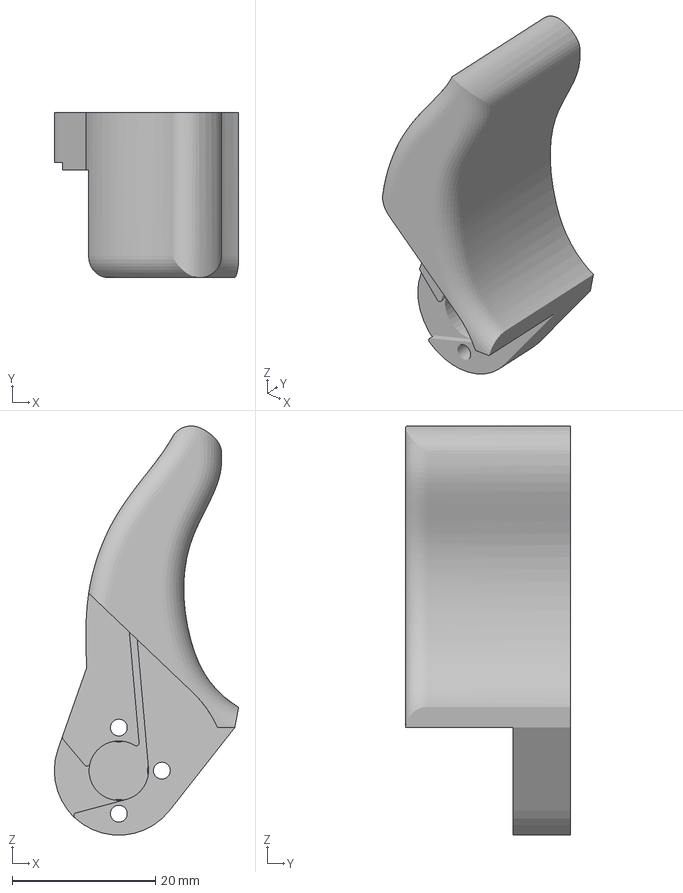
[picture p64: CAD file, 2026-07-21]
docs/files/shared/trigger-right.step
25.7 x 23.0 x 57.0 mm
