modpack-robotics/modpack-robotics.github.io/models/backpack_parts/part_10.step

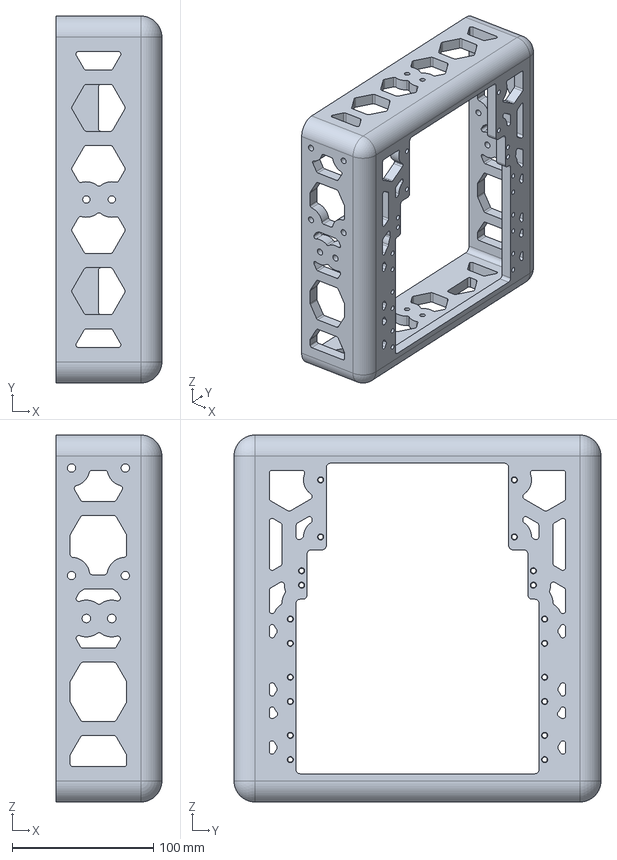
[picture p65: CAD file, 2026-07-21]
models/backpack_parts/part_10.step
75.0 x 260.0 x 260.0 mm
