modpack-robotics/modpack-robotics.github.io/docs/files/backpack/vp-charger-holder.step

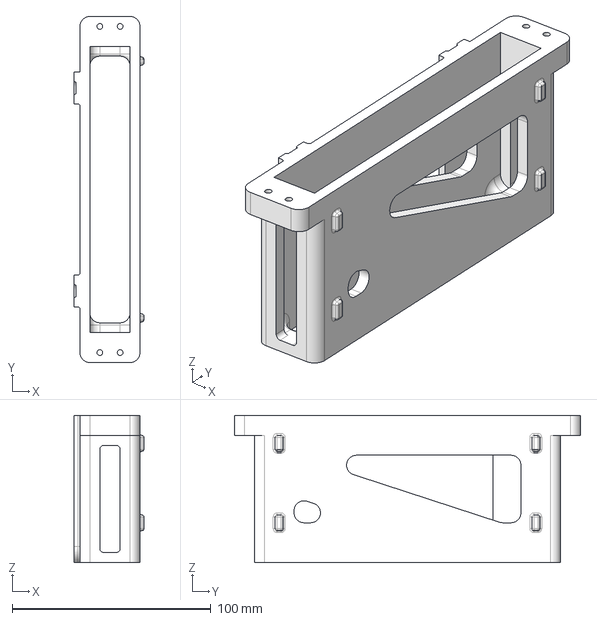
[picture p66: CAD file, 2026-07-21]
docs/files/backpack/vp-charger-holder.step
35.2 x 174.2 x 74.0 mm
