modpack-robotics/modpack-robotics.github.io/models/arm_right/step/Right Arm - Part 2.step

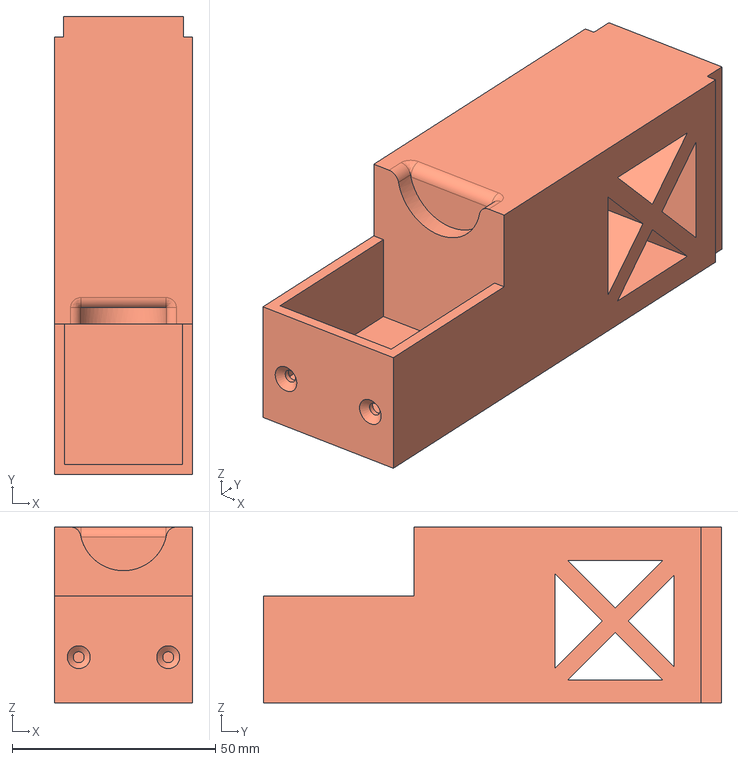
[picture p67: CAD file, 2026-07-21]
models/arm_right/step/Right Arm - Part 2.step
34.0 x 112.6 x 43.2 mm
