modpack-robotics/modpack-robotics.github.io/models/backpack_parts/part_03.step

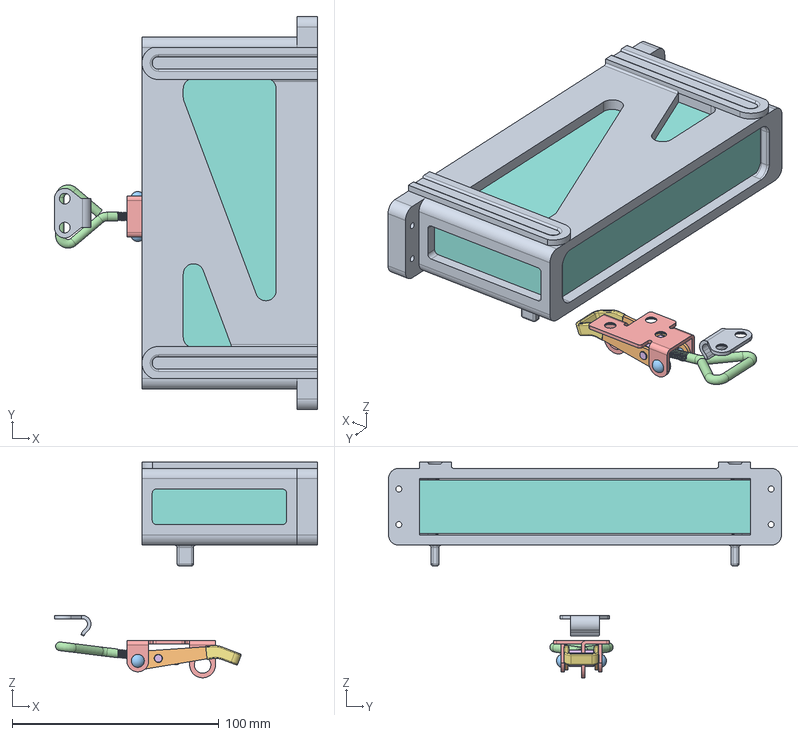
[picture p68: CAD file, 2026-07-21]
models/backpack_parts/part_03.step
127.3 x 190.2 x 104.4 mm
