modpack-robotics/modpack-robotics.github.io/docs/files/arx5/right-shoulder.step

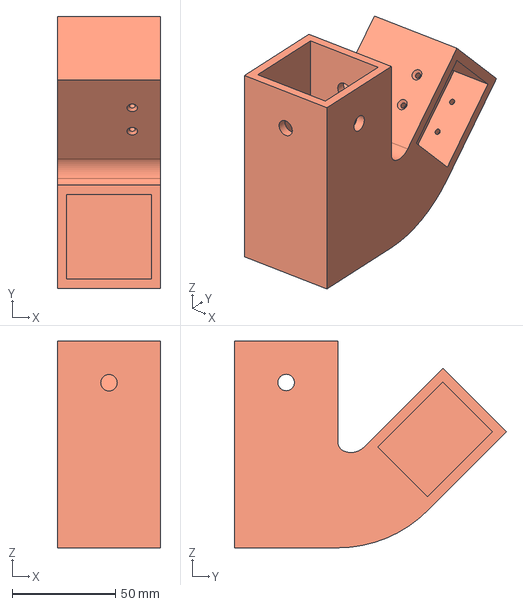
[picture p69: CAD file, 2026-07-21]
docs/files/arx5/right-shoulder.step
50.0 x 131.6 x 100.0 mm
