modpack-robotics/modpack-robotics.github.io/docs/files/backpack/front-panel.step

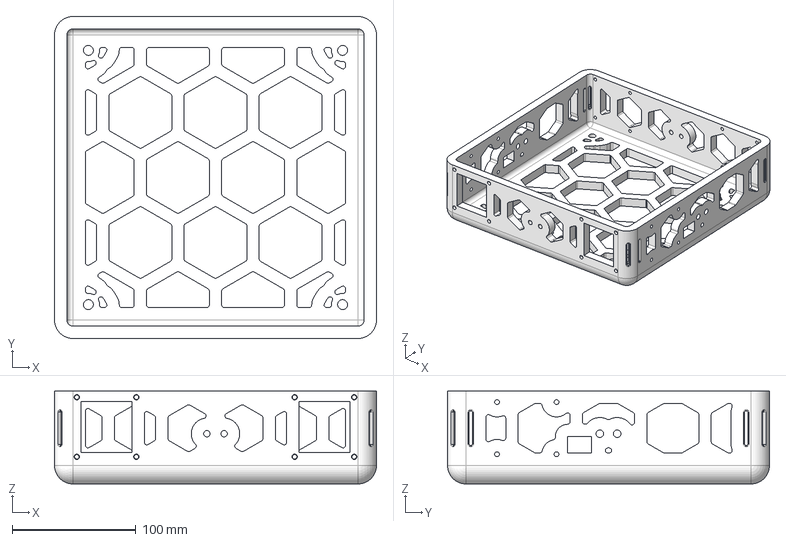
[picture p70: CAD file, 2026-07-21]
docs/files/backpack/front-panel.step
260.0 x 260.0 x 75.0 mm
