modpack-robotics/modpack-robotics.github.io/docs/files/rby1m/link6.step

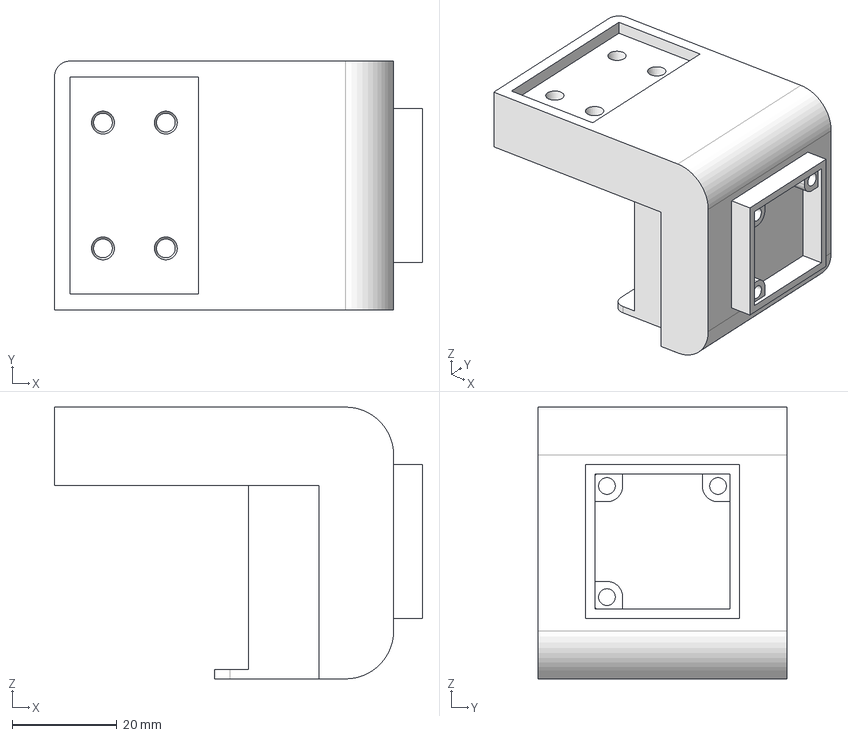
[picture p71: CAD file, 2026-07-21]
docs/files/rby1m/link6.step
70.2 x 47.5 x 51.9 mm
