modpack-robotics/modpack-robotics.github.io/models/backpack_parts/part_09.step

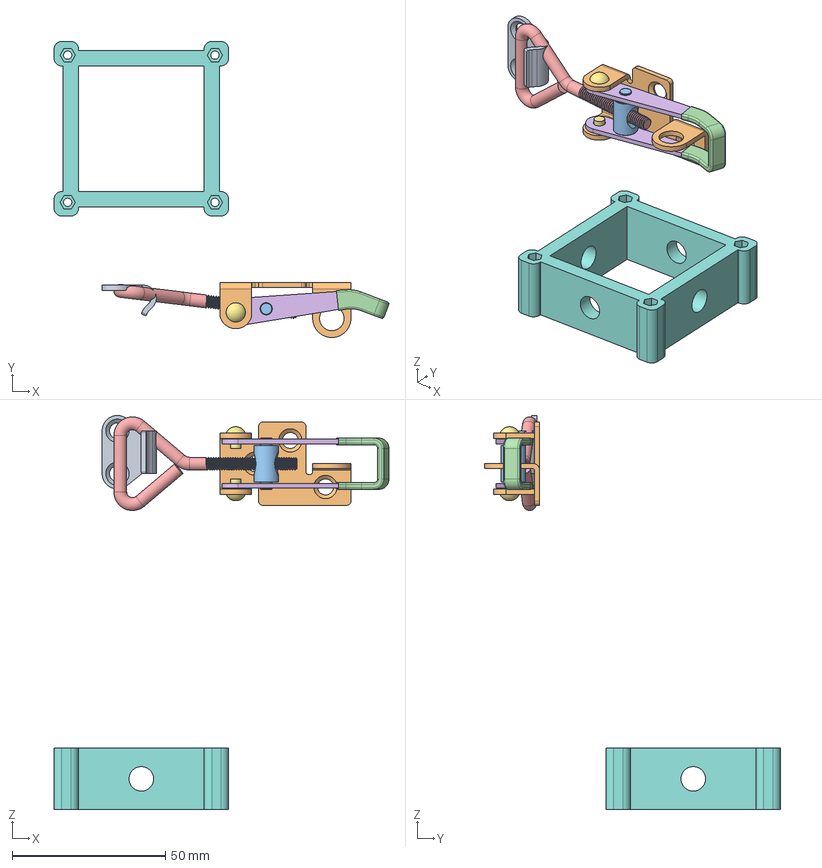
[picture p72: CAD file, 2026-07-21]
models/backpack_parts/part_09.step
109.4 x 96.7 x 128.6 mm
