modpack-robotics/modpack-robotics.github.io/docs/files/arx5/link2.step

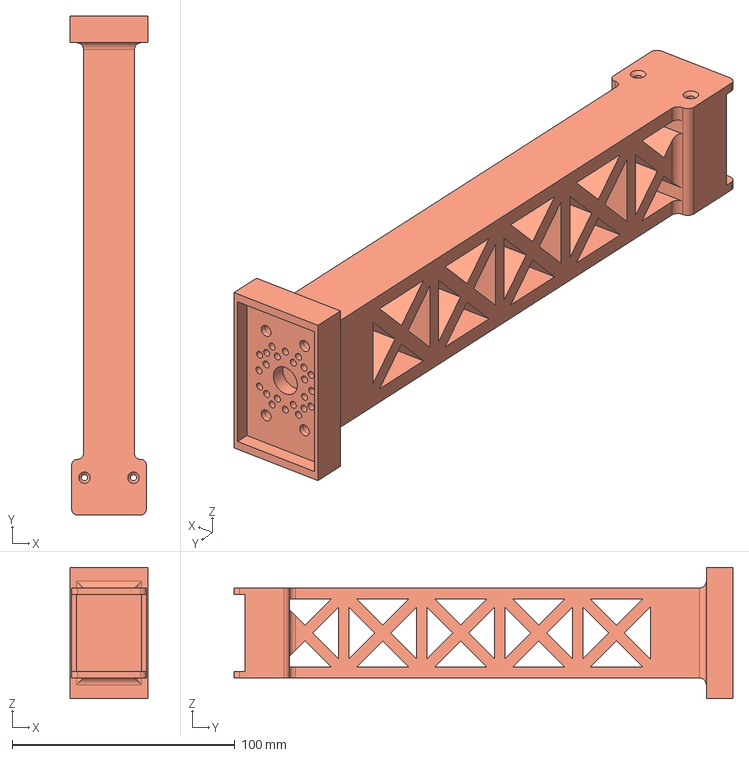
[picture p73: CAD file, 2026-07-21]
docs/files/arx5/link2.step
35.0 x 224.0 x 58.9 mm
