modpack-robotics/modpack-robotics.github.io/docs/files/rby1m/link4.step

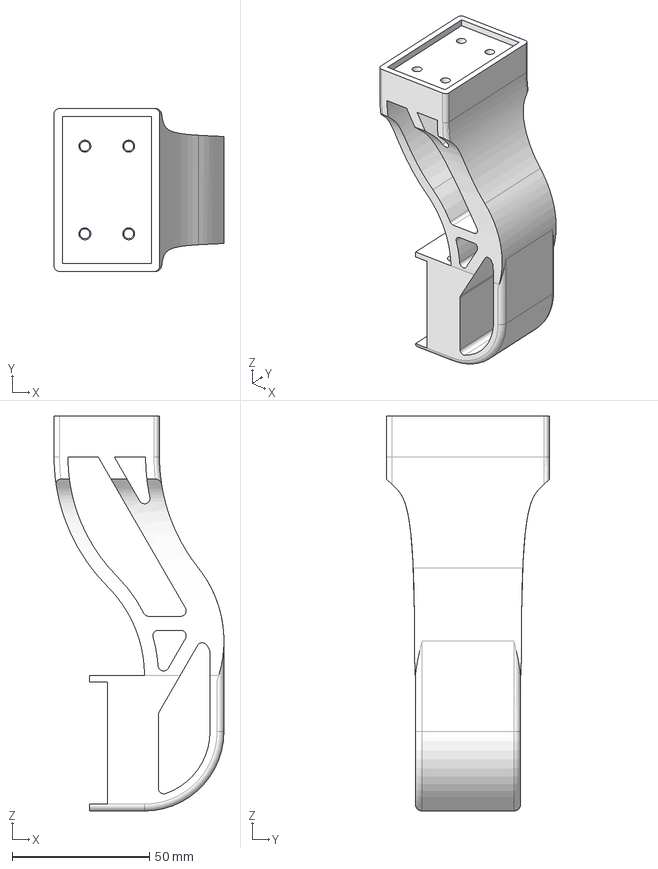
[picture p74: CAD file, 2026-07-21]
docs/files/rby1m/link4.step
62.0 x 59.5 x 144.1 mm
