modpack-robotics/modpack-robotics.github.io/models/backpack_parts/part_05.step

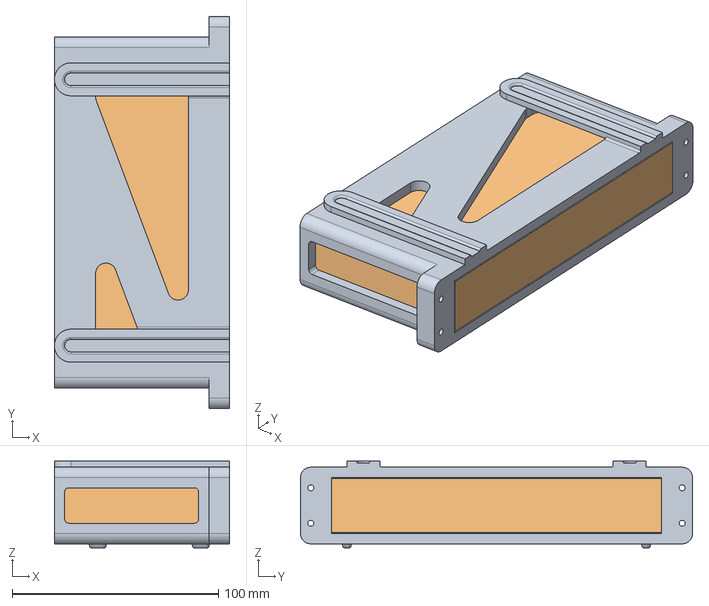
[picture p75: CAD file, 2026-07-21]
models/backpack_parts/part_05.step
85.0 x 190.2 x 42.2 mm
