modpack-robotics/modpack-robotics.github.io/docs/files/backpack/bar-bracket.step

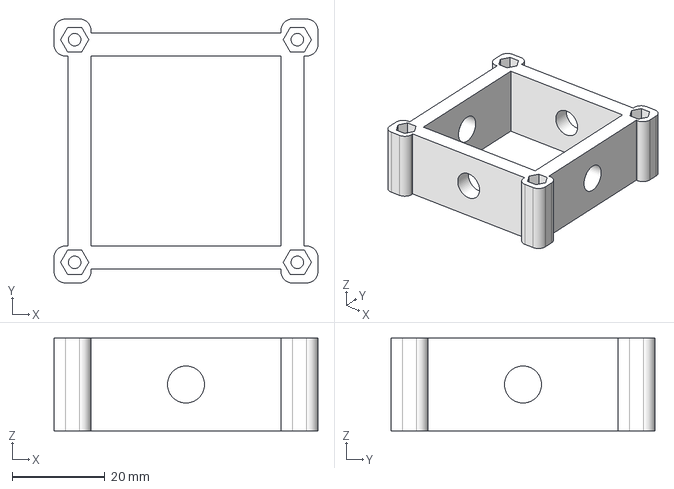
[picture p76: CAD file, 2026-07-21]
docs/files/backpack/bar-bracket.step
57.0 x 57.0 x 20.0 mm
