modpack-robotics/modpack-robotics.github.io/docs/files/rby1m/right-gripper.step

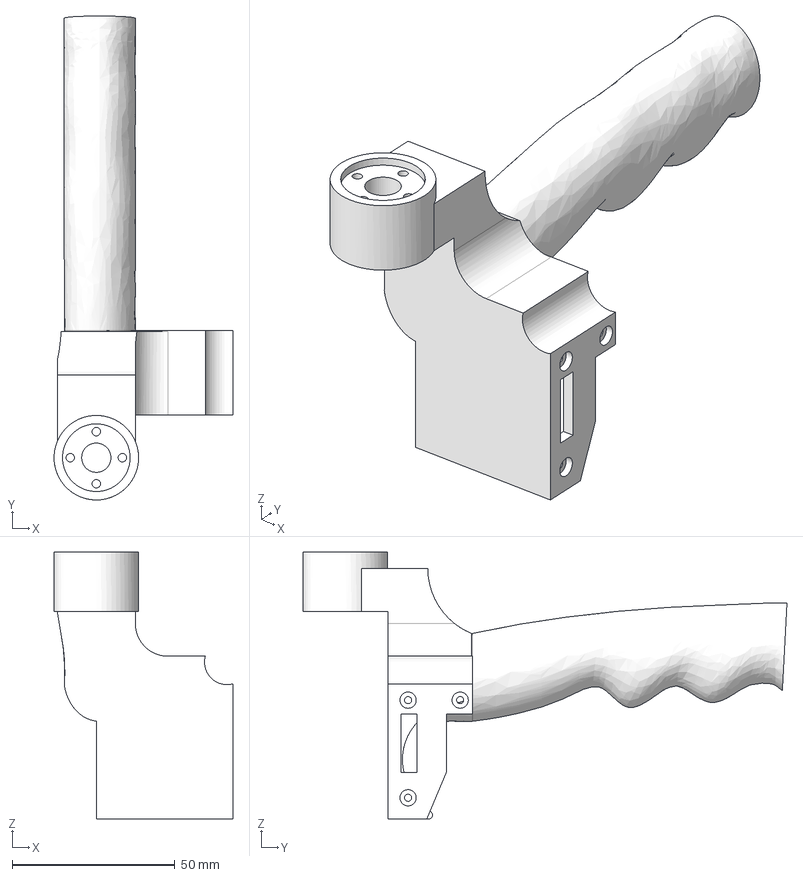
[picture p77: CAD file, 2026-07-21]
docs/files/rby1m/right-gripper.step
55.0 x 148.7 x 82.0 mm
