modpack-robotics/modpack-robotics.github.io/models/backpack_parts/part_01.step

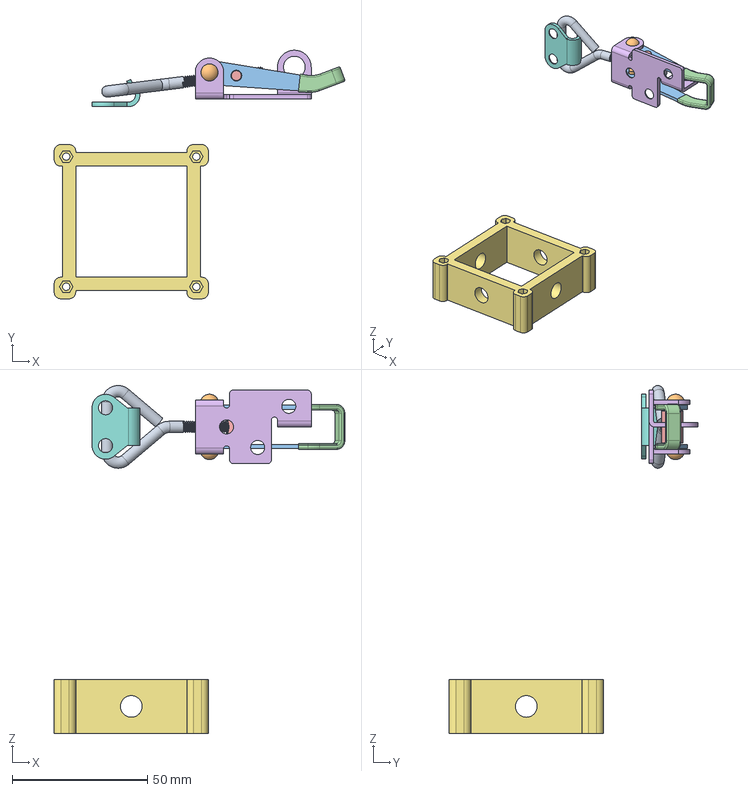
[picture p78: CAD file, 2026-07-21]
models/backpack_parts/part_01.step
107.4 x 91.9 x 128.6 mm
