modpack-robotics/modpack-robotics.github.io/docs/files/arx5/link4.step

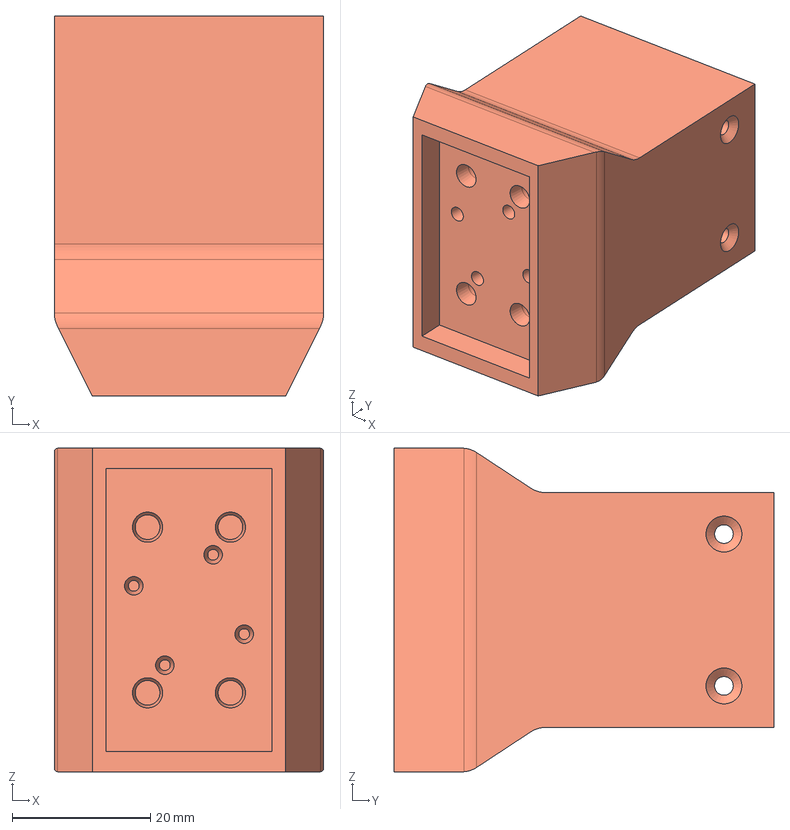
[picture p79: CAD file, 2026-07-21]
docs/files/arx5/link4.step
39.0 x 55.1 x 46.9 mm
