modpack-robotics/modpack-robotics.github.io/docs/files/backpack/shelf-bottom.step

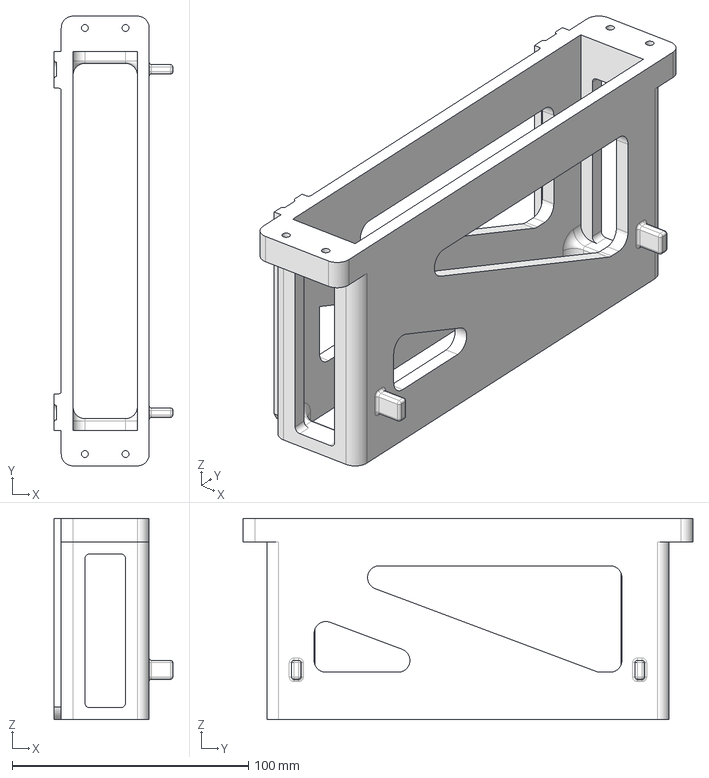
[picture p80: CAD file, 2026-07-21]
docs/files/backpack/shelf-bottom.step
50.2 x 190.2 x 85.0 mm
