modpack-robotics/modpack-robotics.github.io/docs/files/rby1m/link5.step

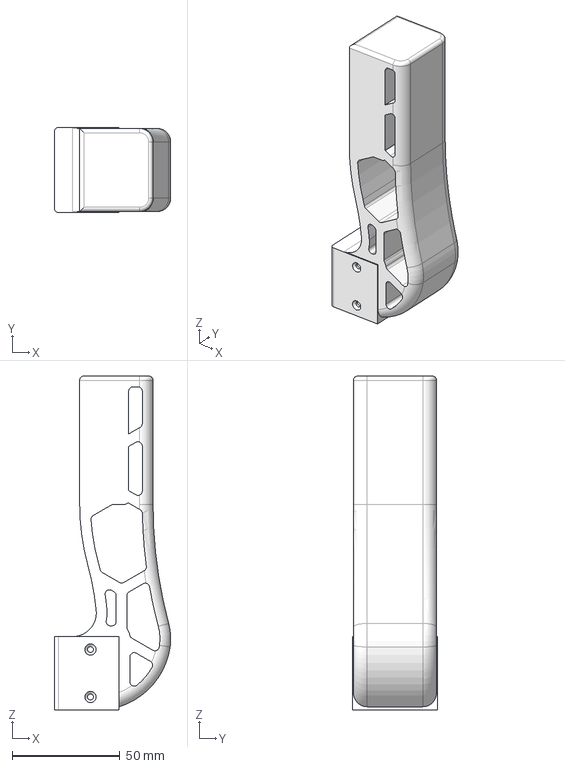
[picture p81: CAD file, 2026-07-21]
docs/files/rby1m/link5.step
53.9 x 39.5 x 154.7 mm
