modpack-robotics/modpack-robotics.github.io/models/backpack_parts/part_06.step

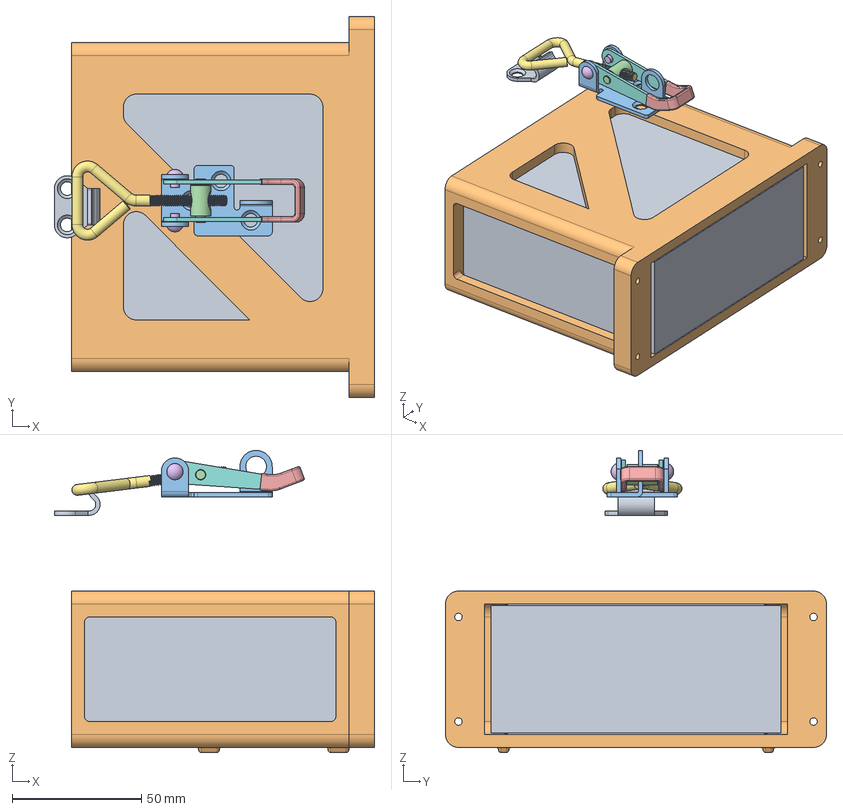
[picture p82: CAD file, 2026-07-21]
models/backpack_parts/part_06.step
123.8 x 147.2 x 116.8 mm
