modpack-robotics/modpack-robotics.github.io/docs/files/arx5/link1.step

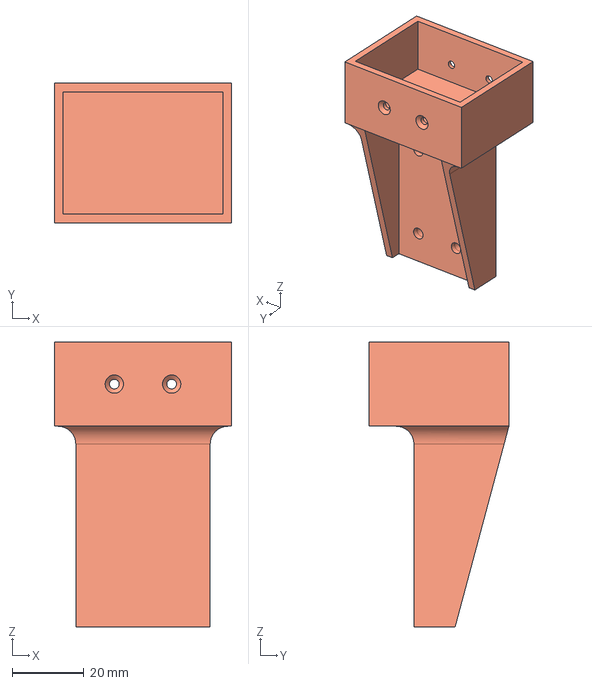
[picture p83: CAD file, 2026-07-21]
docs/files/arx5/link1.step
49.5 x 39.0 x 79.5 mm
