modpack-robotics/modpack-robotics.github.io/docs/files/rby1m/link3.step

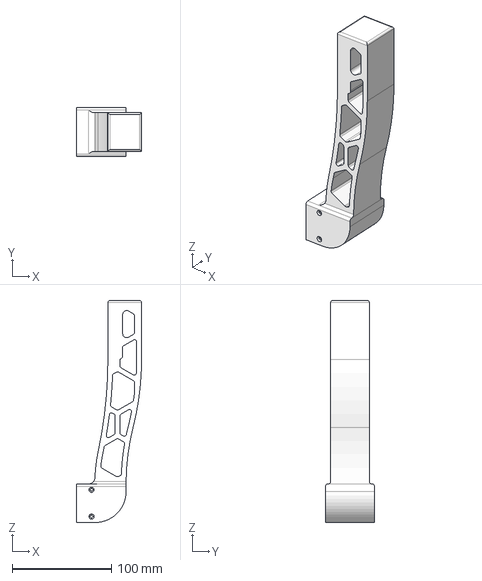
[picture p85: CAD file, 2026-07-21]
docs/files/rby1m/link3.step
65.8 x 49.5 x 224.2 mm
