modpack-robotics/modpack-robotics.github.io/models/backpack_parts/part_08.step

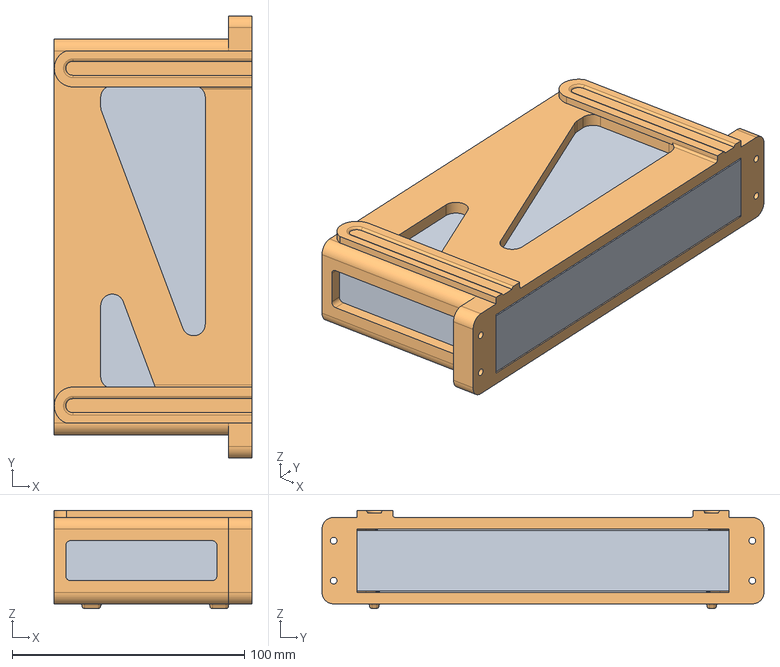
[picture p86: CAD file, 2026-07-21]
models/backpack_parts/part_08.step
85.0 x 190.2 x 42.2 mm
