modpack-robotics/modpack-robotics.github.io/docs/files/backpack/shelf-top.step

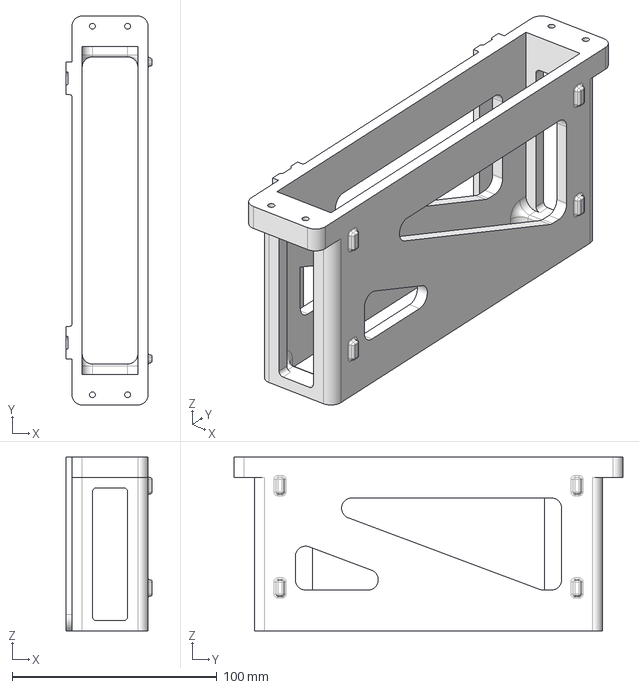
[picture p87: CAD file, 2026-07-21]
docs/files/backpack/shelf-top.step
42.2 x 190.2 x 85.0 mm
