modpack-robotics/modpack-robotics.github.io/docs/files/rby1m/link1.step

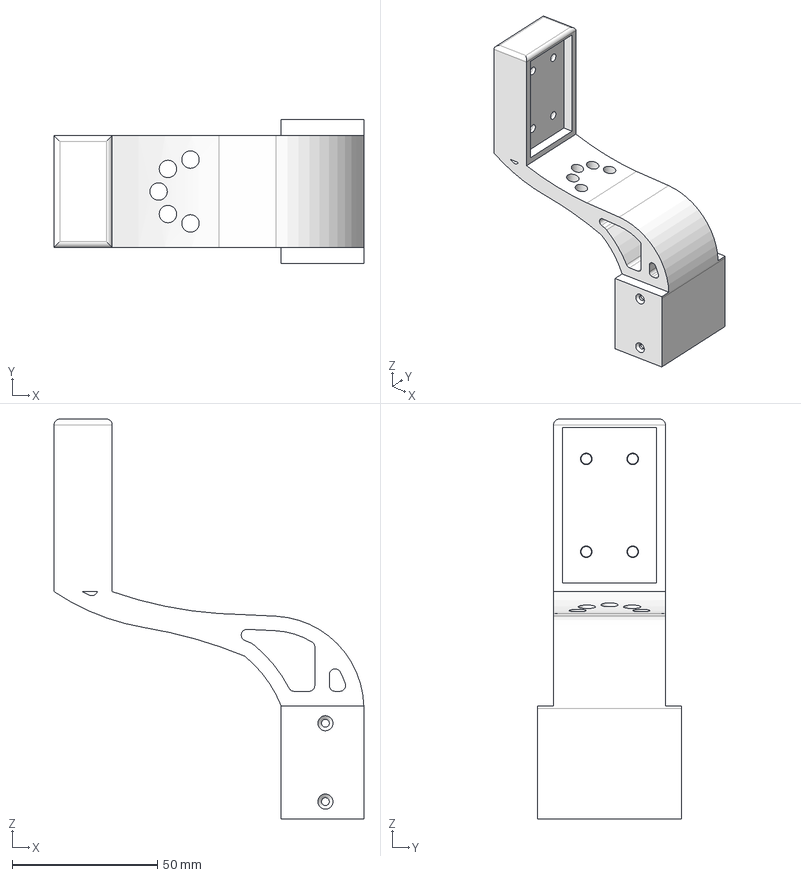
[picture p88: CAD file, 2026-07-21]
docs/files/rby1m/link1.step
106.8 x 49.5 x 137.9 mm
