modpack-robotics/modpack-robotics.github.io/models/backpack_parts/part_07.step

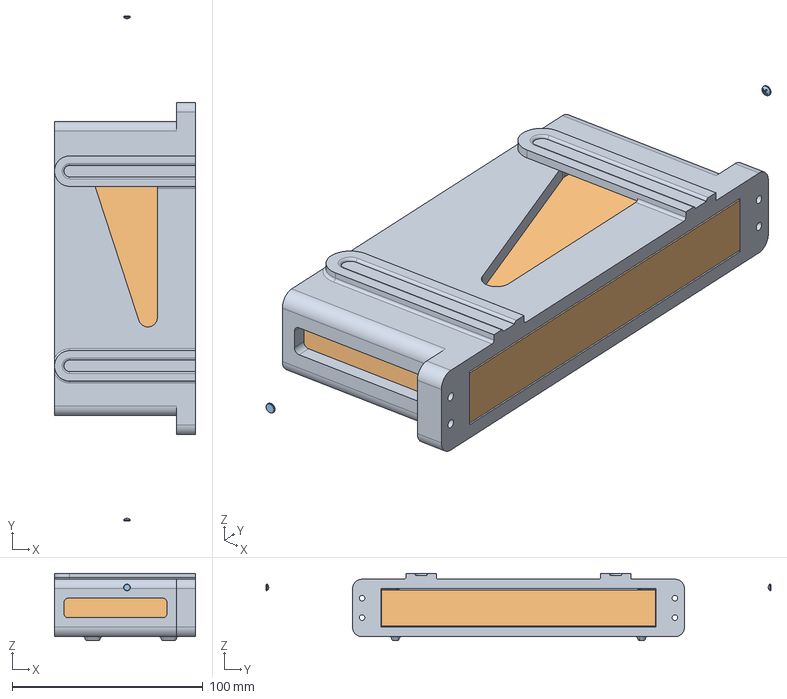
[picture p89: CAD file, 2026-07-21]
models/backpack_parts/part_07.step
74.0 x 264.8 x 35.2 mm
