modpack-robotics/modpack-robotics.github.io/docs/files/backpack/toggle-latch.step

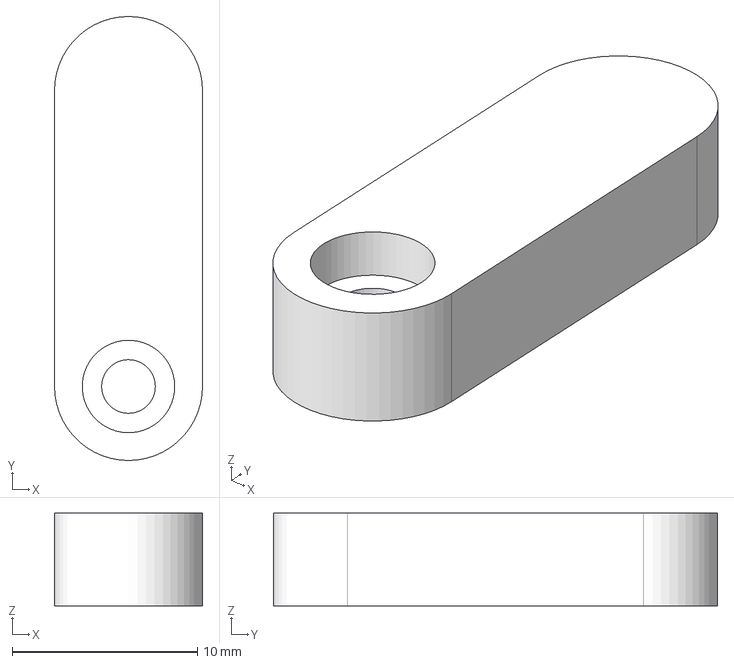
[picture p90: CAD file, 2026-07-21]
docs/files/backpack/toggle-latch.step
8.00 x 24.0 x 5.00 mm
