modpack-robotics/modpack-robotics.github.io/models/backpack_parts/part_04.step

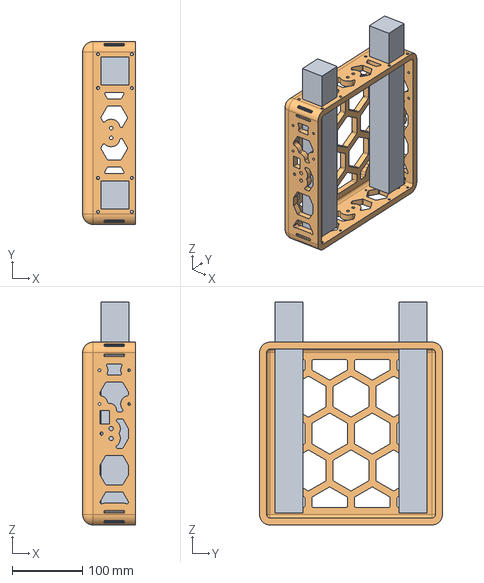
[picture p91: CAD file, 2026-07-21]
models/backpack_parts/part_04.step
75.0 x 260.0 x 317.0 mm
