modpack-robotics/modpack-robotics.github.io/docs/files/arx5/link3.step

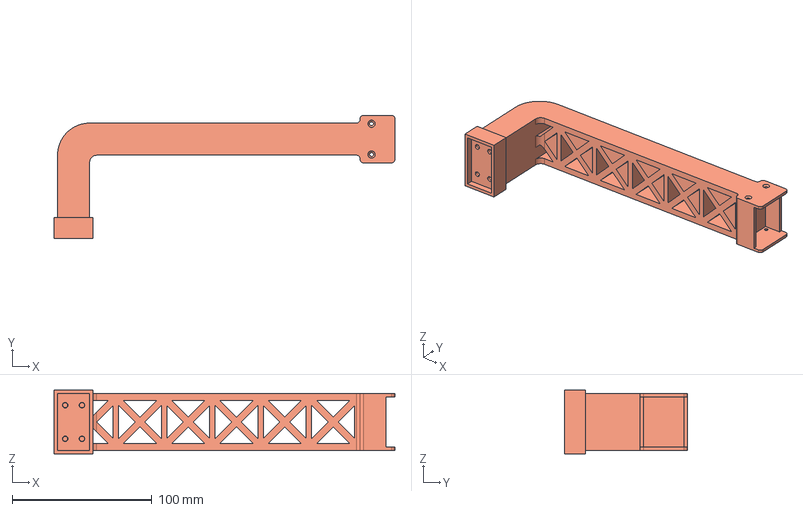
[picture p92: CAD file, 2026-07-21]
docs/files/arx5/link3.step
243.7 x 88.1 x 45.5 mm
