modpack-robotics/modpack-robotics.github.io/docs/files/rby1m/link2.step

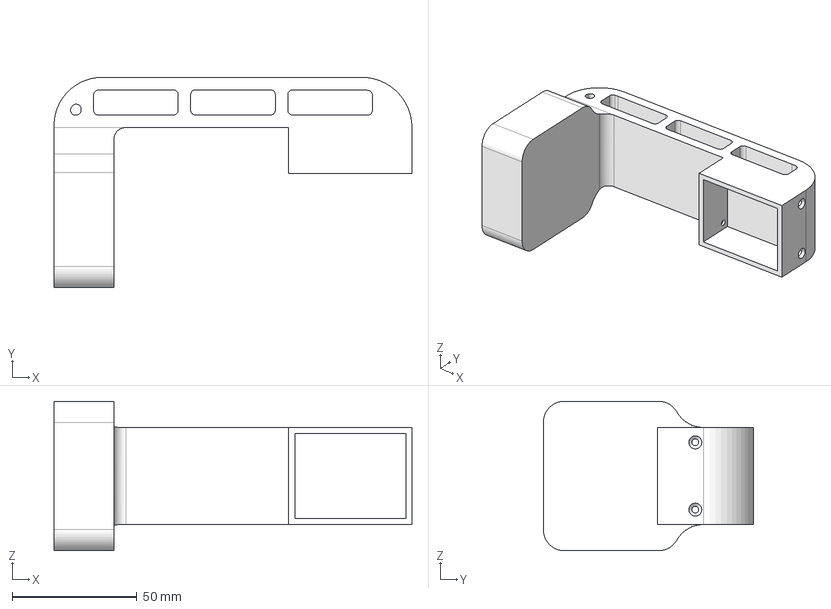
[picture p93: CAD file, 2026-07-21]
docs/files/rby1m/link2.step
143.7 x 84.4 x 60.0 mm
