modpack-robotics/modpack-robotics.github.io/(list of files, cad)

Other CAD files:
docs/files/arx5/left-gripper.step
docs/files/rby1m/right-shoulder.step
docs/files/shared/trigger-left.step
docs/files/backpack/back-panel.step
docs/files/arx5/right-gripper.step
docs/files/arx5/left-shoulder.step
docs/files/rby1m/trigger-holder.step
docs/files/rby1m/left-gripper.step
models/arm_right/parts/Right Arm - Part 2 (1).obj
models/arm_right/parts/Right Arm - Part 2 (2).obj
models/arm_right/parts/Right Arm - Part 2 (3).obj
models/arm_right/parts/Right Arm - Part 2 (4).obj
models/arm_right/parts/Right Arm - Part 2.obj
models/arm_right/parts/Right Arm - Part 4.obj
models/arm_right/parts/Right Arm - right holder.obj
