modpack-robotics/modpack-robotics.github.io/docs/images/ARX_Instructions/holder_instructions.png

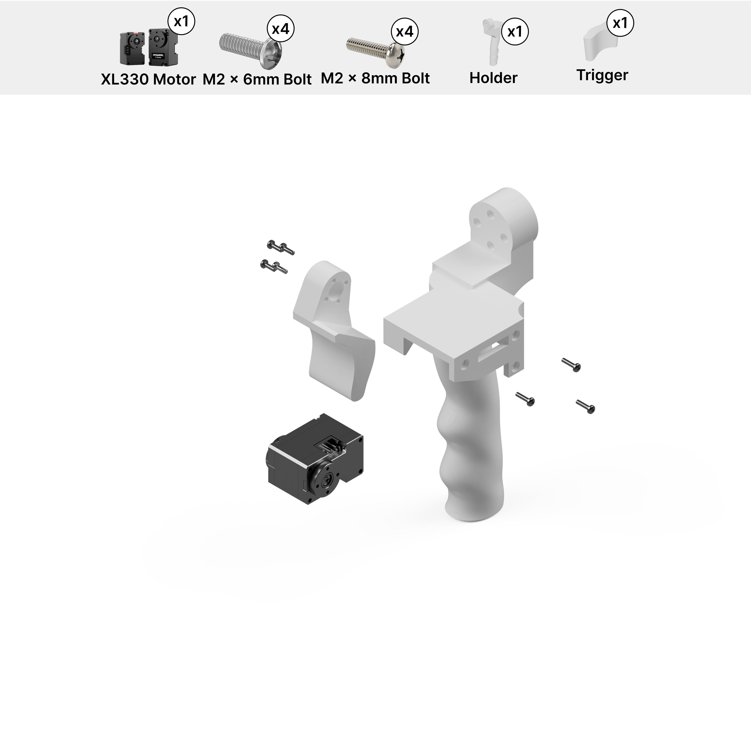
docs/images/ARX_Instructions/holder_instructions.png
