modpack-robotics/modpack-robotics.github.io/docs/images/ARX_Instructions/link_3_instructions.png

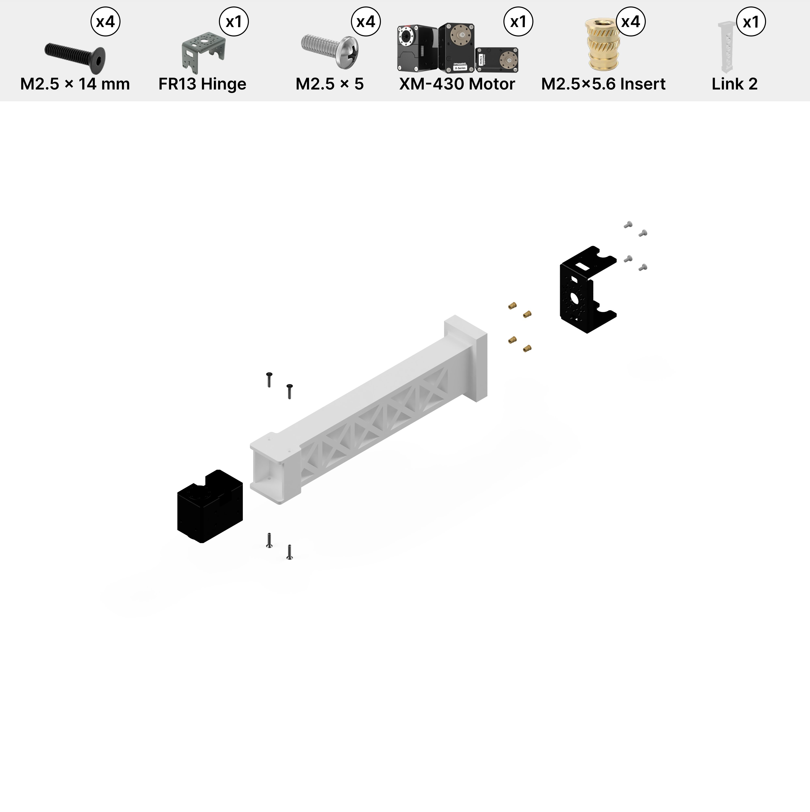
docs/images/ARX_Instructions/link_3_instructions.png
