modpack-robotics/modpack-robotics.github.io/docs/images/ARX_Instructions/link_5_instructions.png

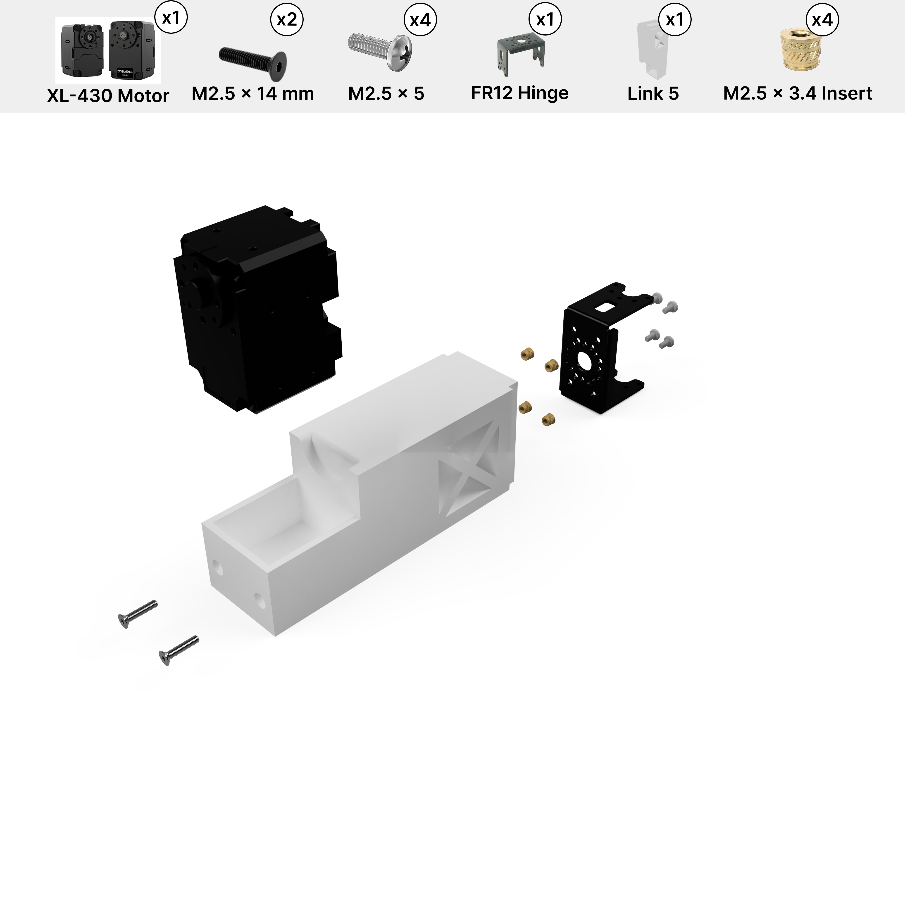
docs/images/ARX_Instructions/link_5_instructions.png
