modpack-robotics/modpack-robotics.github.io/docs/images/shoulder_guide.png

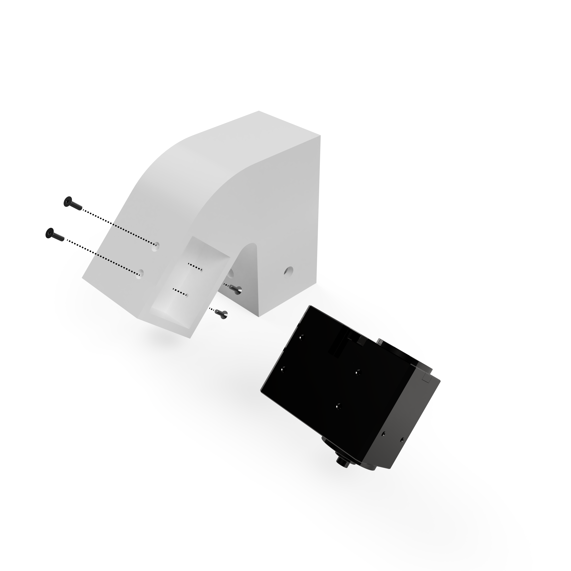
docs/images/shoulder_guide.png
