modpack-robotics/modpack-robotics.github.io/images/backpack_assembled.png

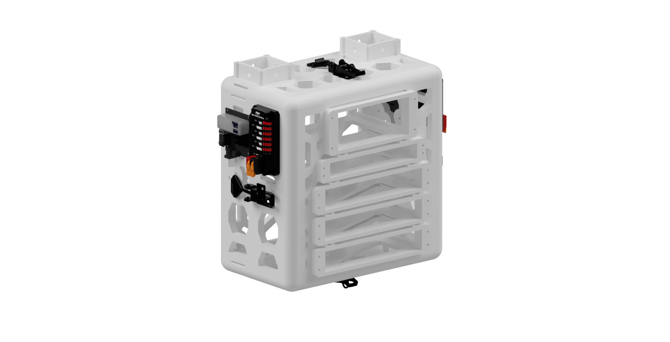
images/backpack_assembled.png
