modpack-robotics/modpack-robotics.github.io/(commit log)

2026-07-21 BOM: add Off-the-Shelf Devices (Vision Pro, iPhone); teleop: add Recycle task video
2026-07-21 Draco-compress 3D models for fast arm-viewer loading
2026-08-07 Add indexable favicon + WebSite JSON-LD for search display; use video first frame as teaser poster
